fouille/acw02_esphome/docs/version_xiao_esp32_C3_C6.md

# XIAO ESP32 C3-C6 version
## 🧩 PCB

### 📂 Gerber files available in the `PCB/` directory:

#### 🟢 Stable version (v1.0) :
📥 [Download GERBER file](https://github.com/devildant/acw02_esphome/raw/main/PCB/lolin_c3_xiao_c3_xiao_c6/v1.0/Gerber_climEspHome_esp32_lolin_c3_xiao_c3_c6_PCB_climEspHome_esp32_lolin_c3_xia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)

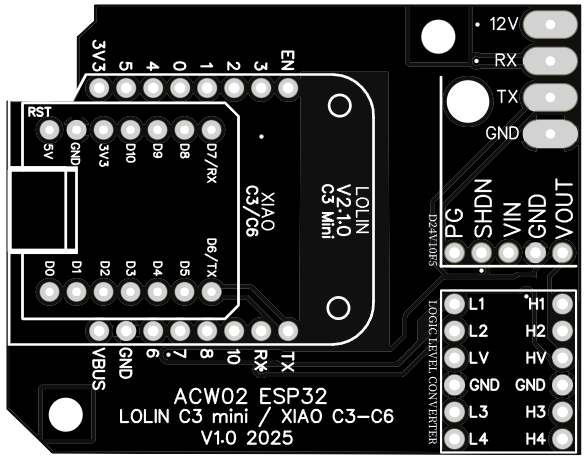
[picture p1: PCB/images/pcb/front-v1.0-C3-C6.PNG]
front
  
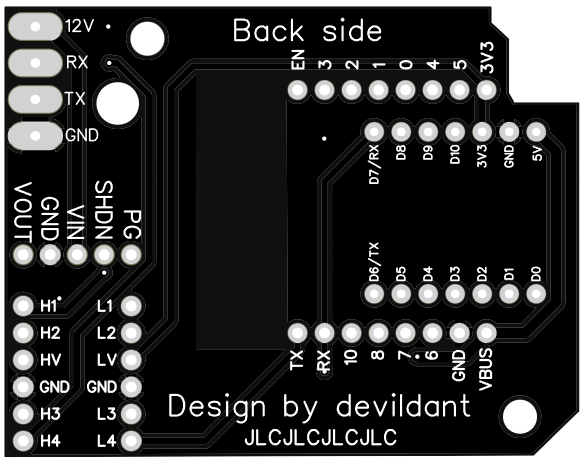
[picture p2: PCB/images/pcb/back-v1.0-C3-C6.PNG]
back


---

### 📦 Components

- **[ESP32 xiao C3 or C6 (x1)]**
  - **[LOLIN ESP32 C3 (x1)](https://www.seeedstudio.com/Seeed-XIAO-ESP32C3-p-5431.html)**  
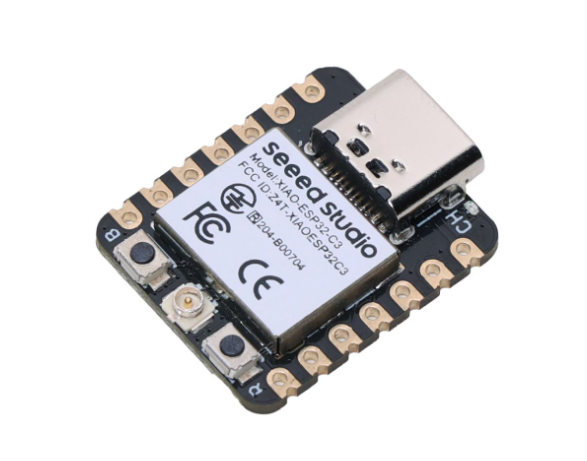
[picture p3: PCB/images/components/XIAO-ESP32-C3.PNG]
  
  - **[LOLIN ESP32 C6 (x1)](https://www.seeedstudio.com/Seeed-Studio-XIAO-ESP32C6-p-5884.html)**  
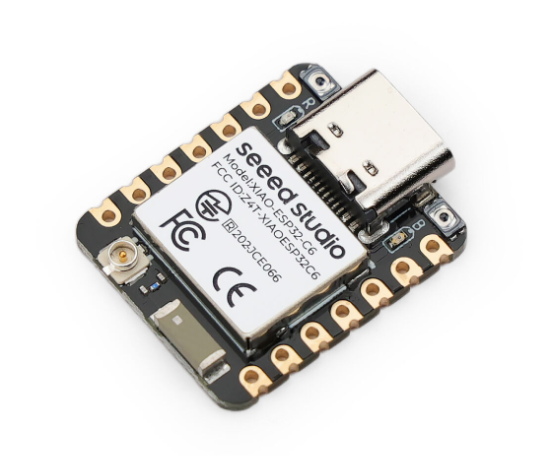
[picture p4: PCB/images/components/XIAO-ESP32-C6.PNG]
  
    - **[external antenna (for c6 only because not provide, and internal antenna has very poor reception) (x1)](https://www.seeedstudio.com/2-4GHz-FPC-Antenna-2-9dBi-for-XIAO-ESP32C3-p-6439.html)**  
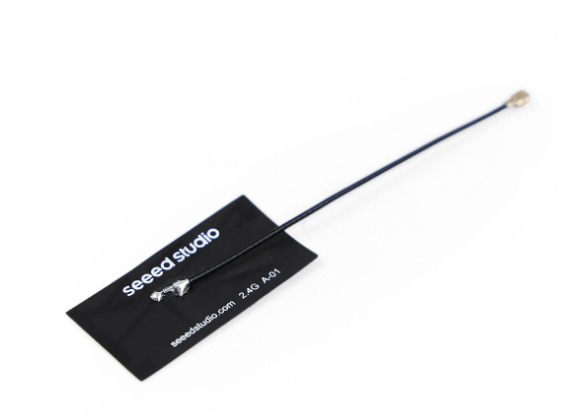
[picture p5: PCB/images/components/XIAO-ESP32-C6-antenna.PNG]
    

- **[7 pins male 2.54mm (x2): MaleL7.5-1X7P](https://fr.aliexpress.com/item/1005007128029220.html)**  
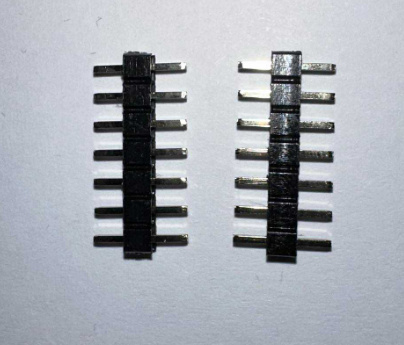
[picture p6: PCB/images/components/7 pin male 2.54.PNG]
MaleL7.5-1X5P
  

  ---
  
  ### 🧵 PCB Soldering & Wiring
  
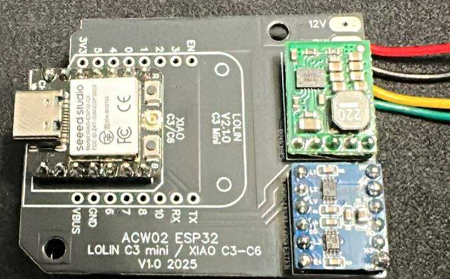
[picture p7: PCB/images/components/pcb front-xiao-C3.PNG]
pcb front xiao c3
    
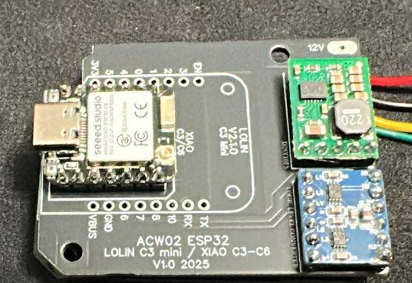
[picture p8: PCB/images/components/pcb front-xiao-C6.PNG]
pcb front xiao c6
    
  
  - RED = 12V  
  - BLACK = RX  
  - YELLOW = TX  
  - GREEN = GND

---

### 🧰 Solder Board Helper

[solder board ESP32 C3-C6.stl](https://github.com/devildant/acw02_esphome/raw/main/3Dfiles/LOLIN-C3-XIAO-C3-C6/solder%20board%20ESP32%20C3-C6.stl)  
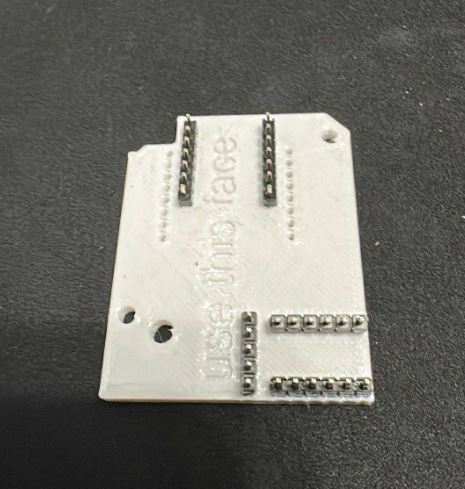
[picture p9: 3Dfiles/images/solder board1-xiao-c3-c6.jpg]
solder1
  
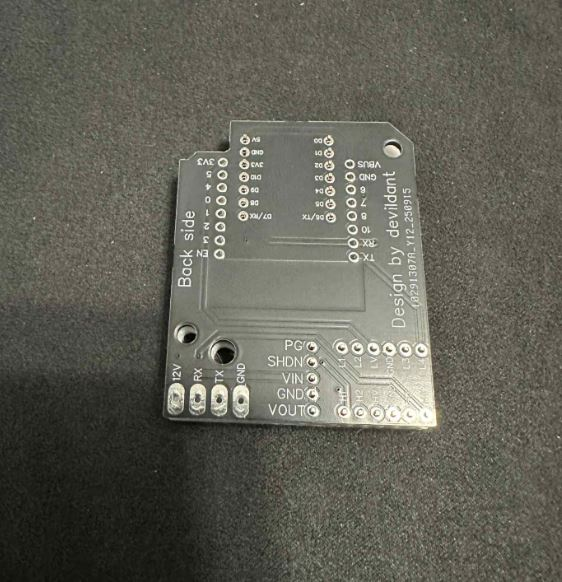
[picture p10: 3Dfiles/images/solder board2-xiao-c3-c6.jpg]
solder2
