fouille/acw02_esphome/docs/version_lolin_esp32_C3.md

# LOLIN ESP32 C3 MINI version
## 🧩 PCB

### 📂 Gerber files available in the `PCB/` directory:

#### 🟢 Stable version (v1.0) :
📥 [Download GERBER file](https://github.com/devildant/acw02_esphome/raw/main/PCB/lolin_c3_xiao_c3_xiao_c6/v1.0/Gerber_climEspHome_esp32_lolin_c3_xiao_c3_c6_PCB_climEspHome_esp32_lolin_c3_xia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)

front  
back

---

### 📦 Components

- **[LOLIN ESP32 C3 mini (x1)](https://www.wemos.cc/en/latest/c3/c3_mini.html)**  
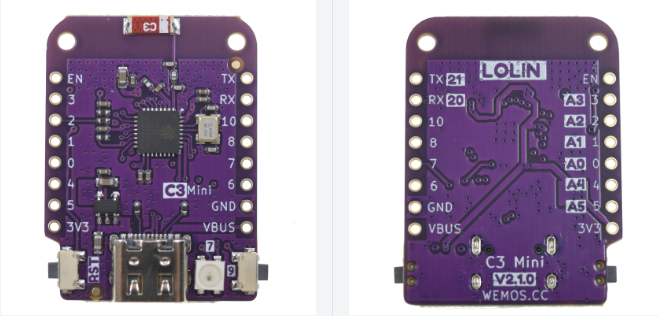
[picture p11: PCB/images/components/LOLIN-ESP32-C-MINI.PNG]
ESP32
  

- **[8 pins male 2.54mm (x2): MaleL7.5-1X8P](https://fr.aliexpress.com/item/1005007128029220.html)**  
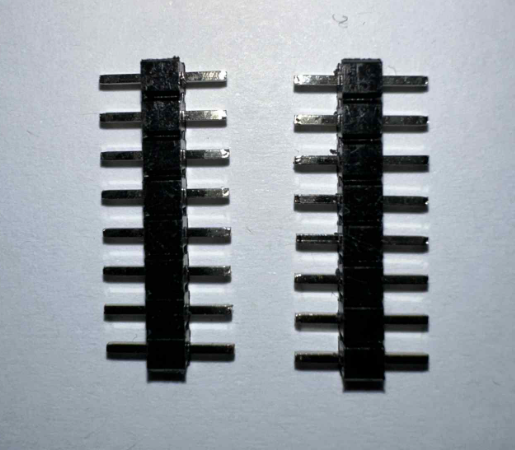
[picture p12: PCB/images/components/8 pin male 2.54.PNG]
MaleL7.5-1X5P
  

  ---
  
  ### 🧵 PCB Soldering & Wiring
  
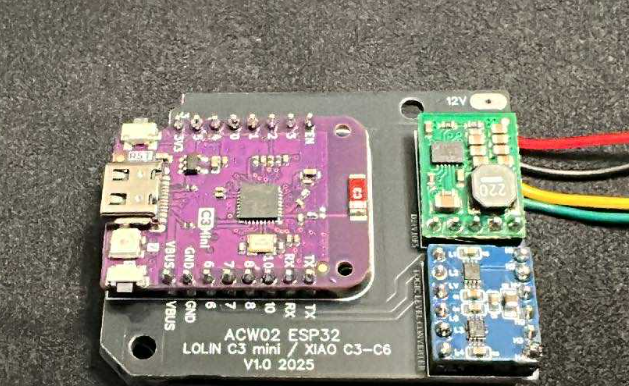
[picture p13: PCB/images/components/pcb front-lolin-c3.PNG]
pcb front
    
  
  - RED = 12V  
  - BLACK = RX  
  - YELLOW = TX  
  - GREEN = GND

---

### 🧰 Solder Board Helper

[solder board ESP32 C3-C6.stl](https://github.com/devildant/acw02_esphome/raw/main/3Dfiles/LOLIN-C3-XIAO-C3-C6/solder%20board%20ESP32%20C3-C6.stl)  
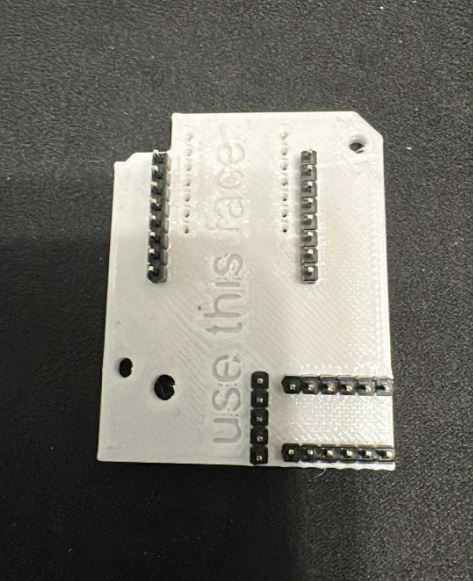
[picture p14: 3Dfiles/images/solder board1-lolin-c3.jpg]
solder1
  
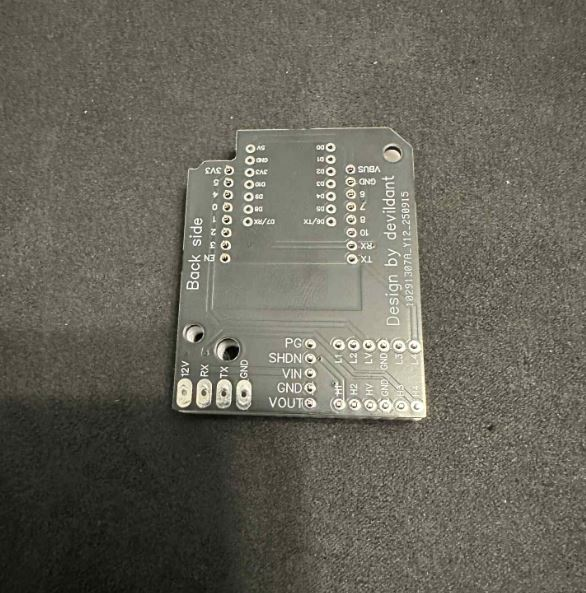
[picture p15: 3Dfiles/images/solder board2-lolin-c3.jpg]
solder2
