fouille/acw02_esphome/docs/en/README.md

# ACW02 Documentation (English)

Welcome to the complete English documentation for the ACW02 project.

## 🚀 Quick Start

1. **[Installation](installation/README.md)** - Complete installation guides
2. **[Hardware Selection](hardware/README.md)** - Choose your ESP32 board
3. **[Usage Guide](usage/README.md)** - Configure and use your module
4. **[Troubleshooting](usage/troubleshooting.md)** - Solve common issues

## 📋 Table of Contents

### Installation
- **[Installation Overview](installation/README.md)** - All installation methods
- **[macOS Installation](installation/macos.md)** - Direct installation on macOS
- **[Windows Installation](installation/windows.md)** - Direct installation on Windows
- **[Docker Installation](installation/docker.md)** - Using Docker containers
- **[Home Assistant Add-on](installation/ha-addon.md)** - ESPHome add-on method

### Hardware
- **[Hardware Overview](hardware/README.md)** - Board comparison and selection
- **[ESP32 D1 Mini](hardware/d1-mini.md)** - Original version with level shifter
- **[LOLIN C3](hardware/lolin-c3.md)** - Compact version without level shifter
- **[XIAO C3/C6](hardware/xiao-c3-c6.md)** - Ultra-compact versions

### Usage
- **[Getting Started](usage/README.md)** - First steps and basic configuration
- **[Interface Details](usage/interface.md)** - Complete interface description
- **[Home Assistant Integration](usage/home-assistant.md)** - HA setup and configuration
- **[Troubleshooting](usage/troubleshooting.md)** - Common problems and solutions

### Advanced Features
- **[Advanced Configuration](advanced/README.md)** - Advanced features overview
- **[MQTT Reference](advanced/mqtt-reference.md)** - Every topic and command
- **[MQTT-Only Mode](advanced/mqtt-only.md)** - Configuration without Home Assistant
- **[Jeedom Integration](advanced/jeedom.md)** - Integration with Jeedom
- **[Custom Presets](advanced/custom-presets.md)** - Creating custom presets
- **[Multi-Zone Setup](advanced/multi-zone.md)** - Multiple unit management
- **[Security Configuration](advanced/security.md)** - Security and encryption
- **[Monitoring](advanced/monitoring.md)** - System monitoring and diagnostics

## 🌍 Other Languages

- **[🇫🇷 Documentation Française](../fr/README.md)** - Complete French documentation

## ⚠️ Important Notes

- Always check [compatibility](../compatibility.md) before installation
- Make sure to use the correct hardware version for your air conditioner
- Follow safety guidelines when working with electrical connections

## 🆘 Need Help?

1. Check the [troubleshooting guide](usage/troubleshooting.md)
2. Review the [compatibility matrix](../compatibility.md)
3. Consult the hardware-specific documentation
4. Check existing GitHub issues

---
*Last updated: December 2024*
