fouille/acw02_esphome/COMPATIBILITY.md

# ACW02 ESPHome Compatibility List

_This file is generated from issues labeled `Compatibility`._

## Airton

| Commercial Model | Ref Model | Status | Notes |
|---|---|---|---|
| 409944 | N/A | ❌ No | These air conditioners use the 409945 module, which although identical to the other wifi modules are different. |
| 409943 | SMVH12L-3A1A3NB(I) | ❌ No | These air conditioners use the 409945 module, which although identical to the other wifi modules are different. |
| 409942 | N/A | ❌ No | These air conditioners use the 409945 module, which although identical to the other wifi modules are different. |
| 409913 | SMVH09B-2A2A3NG | ✅ Yes | _No response_ |
| 409730 | SMVH09B-2A2A3NH(I) | ✅ Yes | _No response_ |
| 409733 | SMVH12B-3A2A3NG(I) | ✅ Yes | _No response_ |
| 409731 | SMVH12B-2A2A3NH(I) | ✅ Yes | _No response_ |

## Teknopoint

| Commercial Model | Ref Model | Status | Notes |
|---|---|---|---|
| TW-SKIV-12 | - | ✅ Yes | No ref model found |
| TW-SKIV-12 | N-TW-SMVH12A-3C1A3NG(I) | ✅ Yes | _No response_ |
