fouille/acw02_esphome/3Dfiles/images/antenna-flexF2.PNG

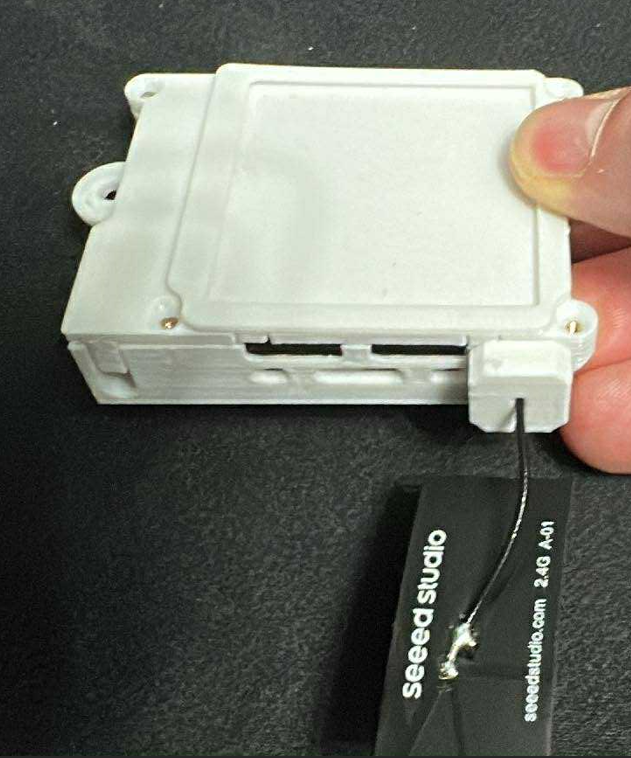
3Dfiles/images/antenna-flexF2.PNG
