fouille/acw02_esphome/3Dfiles/images/antenna-flexF.PNG

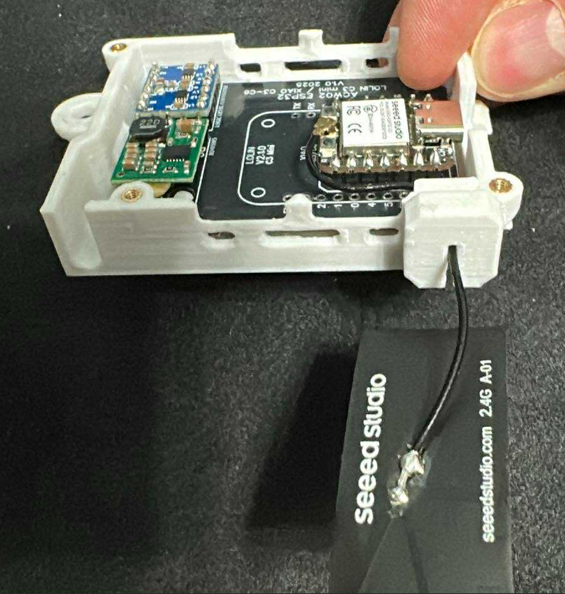
3Dfiles/images/antenna-flexF.PNG
