fouille/acw02_esphome/3Dfiles/images/antenna-flexH2.PNG

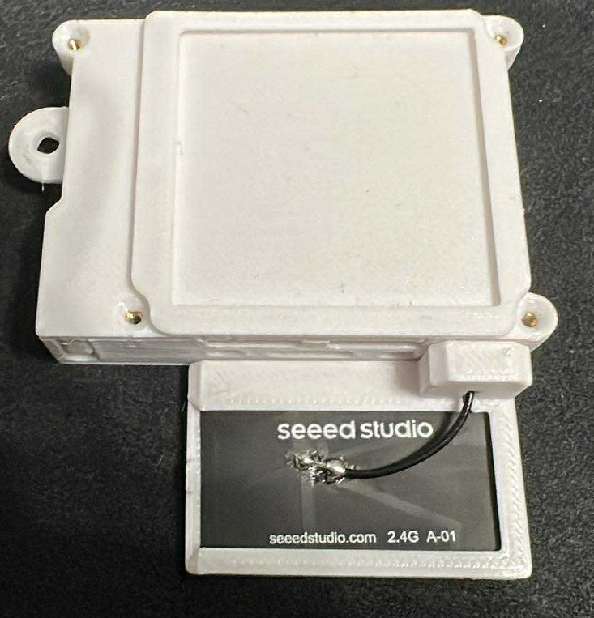
3Dfiles/images/antenna-flexH2.PNG
