fouille/acw02_esphome/3Dfiles/images/antenna-flexH.PNG

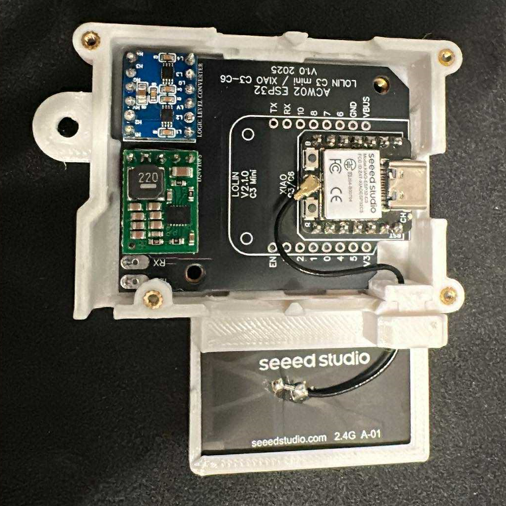
3Dfiles/images/antenna-flexH.PNG
