fouille/acw02_esphome/3Dfiles/images/antenna-flexV2.PNG

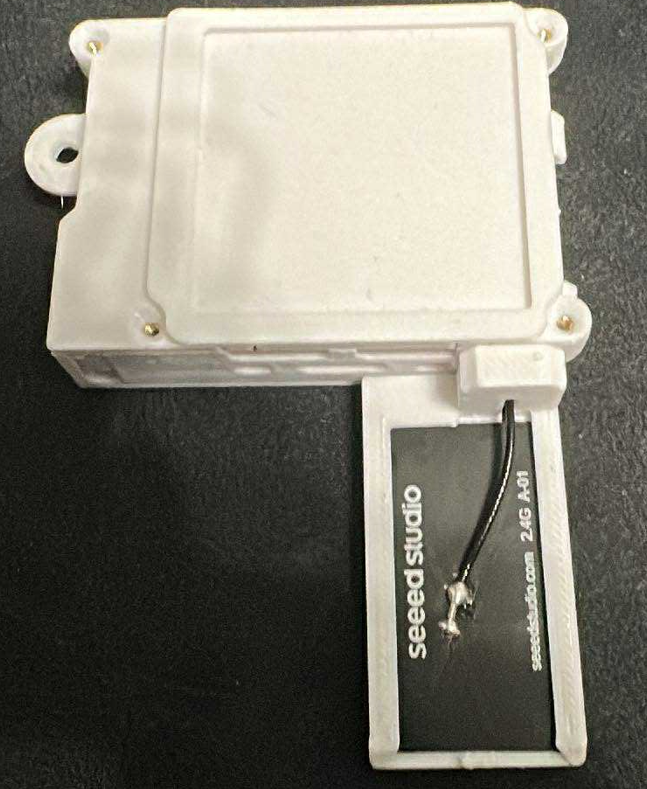
3Dfiles/images/antenna-flexV2.PNG
