fouille/acw02_esphome/3Dfiles/images/antenna-flexV.PNG

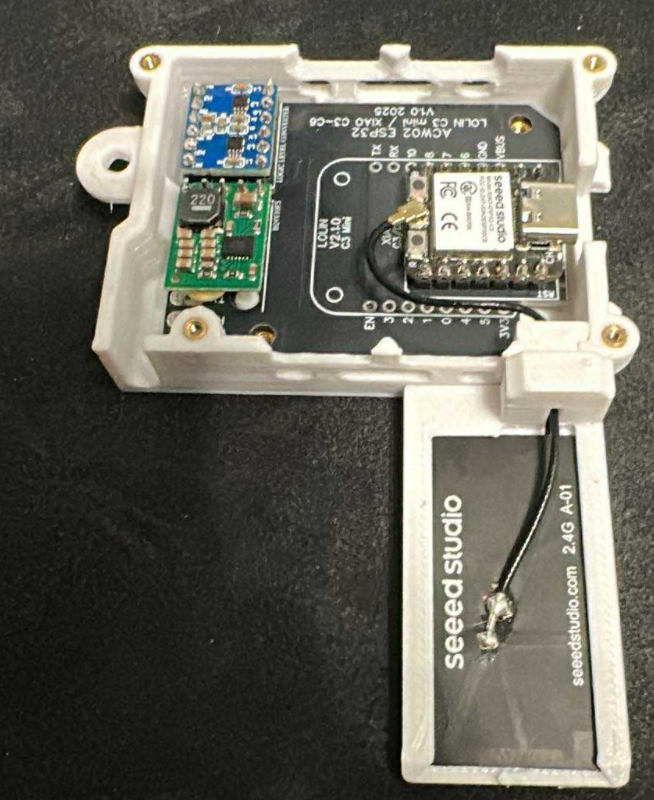
3Dfiles/images/antenna-flexV.PNG
