fouille/acw02_esphome/3Dfiles/images/antenna-rigid.PNG

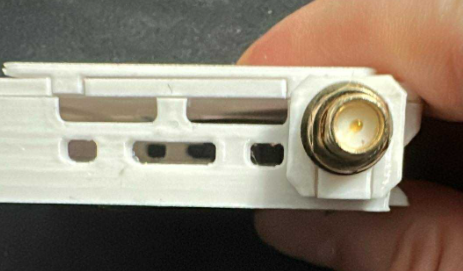
3Dfiles/images/antenna-rigid.PNG
