fouille/acw02_esphome/PCB/logic_level_converter/annexe/image.PNG

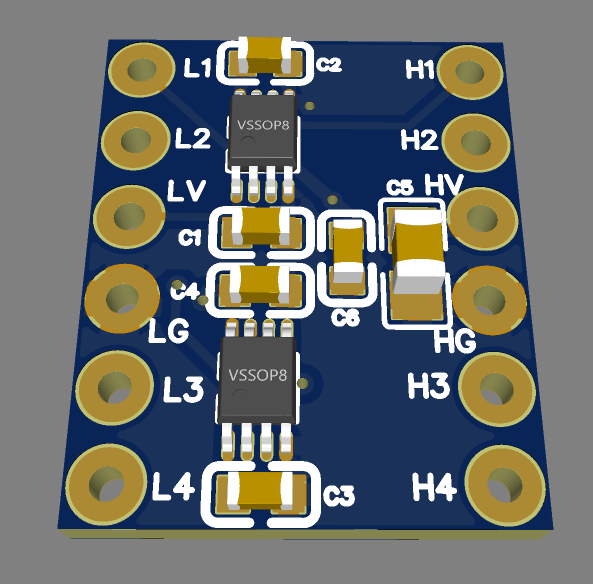
PCB/logic_level_converter/annexe/image.PNG
