fouille/acw02_esphome/3Dfiles/D1-MIMI/button.stl

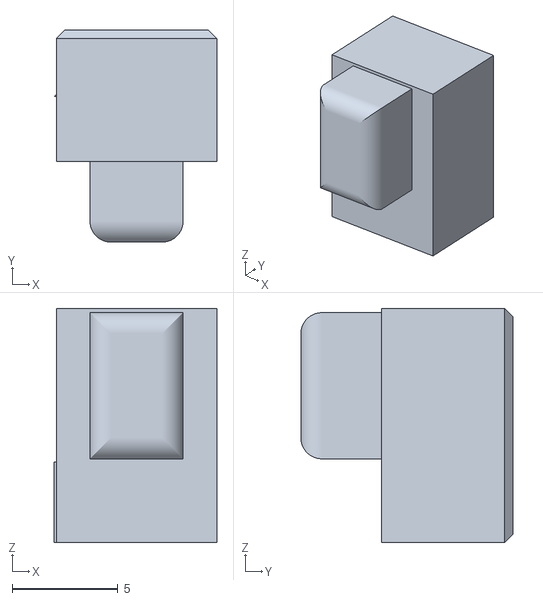
[picture p36: CAD file, 2025-09-27]
3Dfiles/D1-MIMI/button.stl
7.67 x 10.0 x 11.0
