fouille/acw02_esphome/3Dfiles/LOLIN-C3-XIAO-C3-C6/support antenna flex horizontal.stl

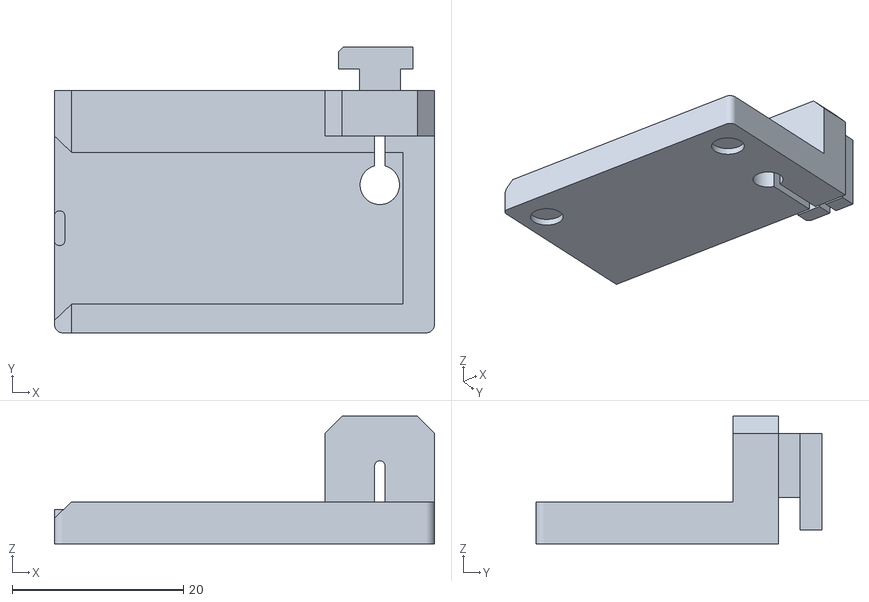
[picture p38: CAD file, 2025-09-27]
3Dfiles/LOLIN-C3-XIAO-C3-C6/support antenna flex horizontal.stl
44.4 x 33.4 x 14.9
