fouille/acw02_esphome/hardware/3d-files/LOLIN-C3-XIAO-C3-C6/solder board ESP32 C3-C6.stl

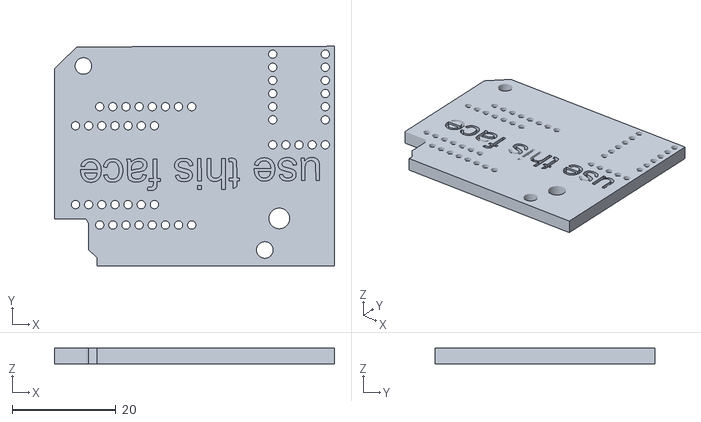
[picture p39: CAD file, 2026-10-30]
hardware/3d-files/LOLIN-C3-XIAO-C3-C6/solder board ESP32 C3-C6.stl
54.1 x 42.4 x 3.00
