fouille/acw02_esphome/hardware/3d-files/support for airton/support airton.stl

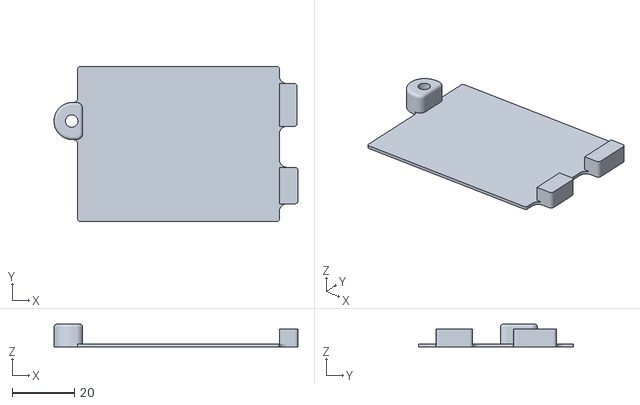
[picture p40: CAD file, 2026-10-30]
hardware/3d-files/support for airton/support airton.stl
78.7 x 50.0 x 7.40
