fouille/acw02_esphome/notUsed/proto pcb for replace level shiffter/annexe/PCB_uart-conv_2025-08-23.dxf

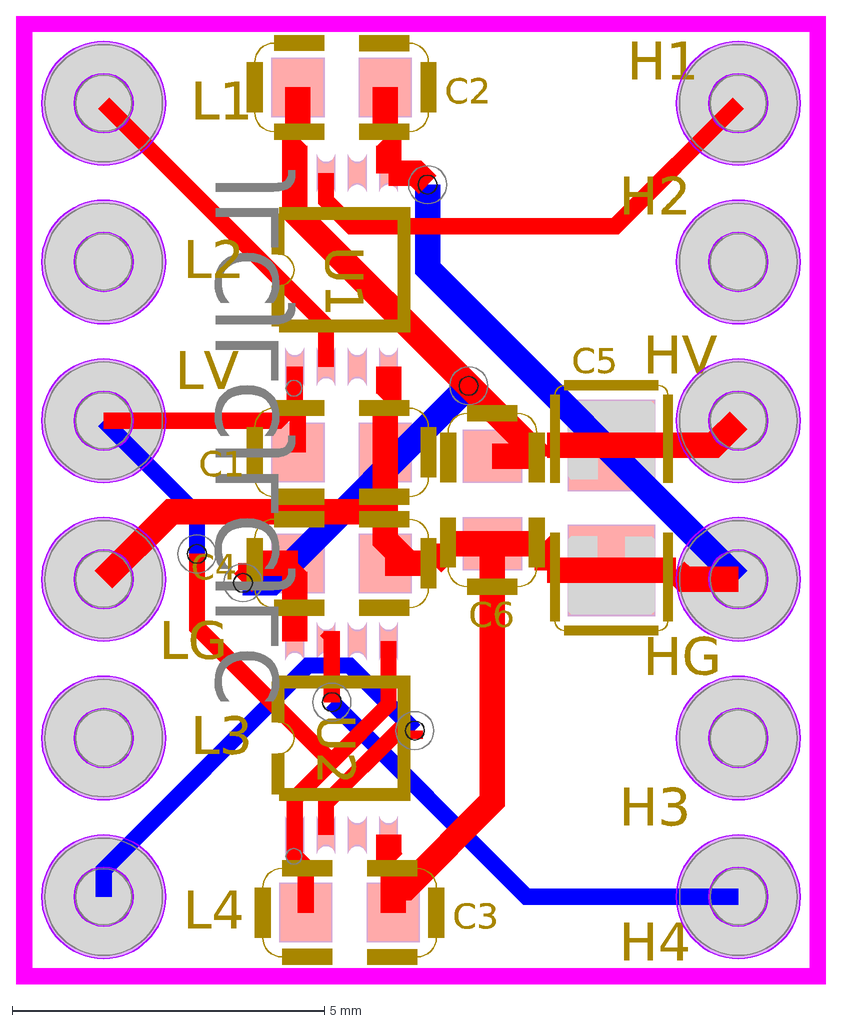
[picture p41: CAD file, 2025-08-23]
notUsed/proto pcb for replace level shiffter/annexe/PCB_uart-conv_2025-08-23.dxf
JLCJLCJLCJLC
U1
U2
H1
H2
H3
H4
HG
HV
L1
L2
L3
L4
LG
LV
C5
C1
C2
C3
C4
C6
