fouille/acw02_esphome/PCB/esp32_D1_mini_wroom32/v1.1/dxf/PCB_climEspHome_esp32_d1_mini_v1.1_2025-09-08.dxf

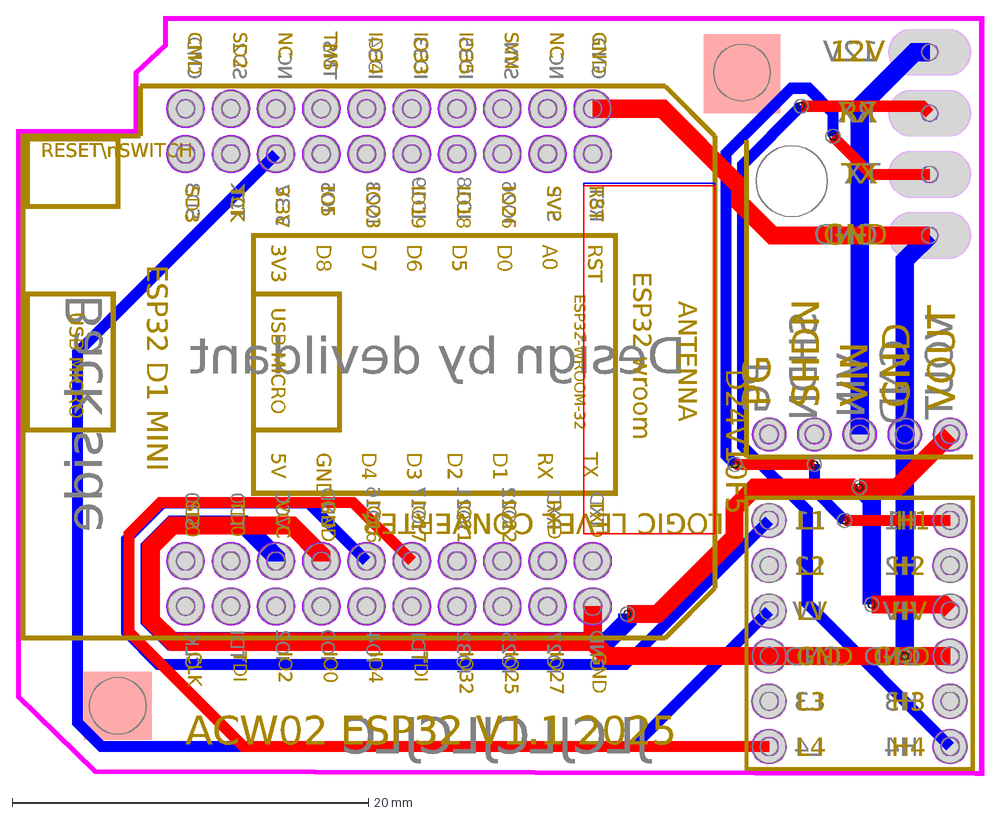
[picture p42: CAD file, 2025-09-08]
PCB/esp32_D1_mini_wroom32/v1.1/dxf/PCB_climEspHome_esp32_d1_mini_v1.1_2025-09-08.dxf
H1
H2
HV
GND
H3
H4
L4
L3
LV
L2
L1
VOUT
VIN
SHDN
PG
12V
RX
TX
IO27
IO25
IO32
TDI
IO4
IO0
IO2
CLK
SD0
TD0
VCC
IO16
IO17
IO21
IO22
RXD
TXD
Back side
Design by devildant
NC
SVN
IO35
IO33
IO34
TMS
SD2
CMD
SD3
TCK
3.3V
IO5
IO23
IO19
IO18
IO26
SVP
RST
JLCJLCJLCJLC
ACW02 ESP32 V1.1 2025
D24V10F5
LOGIC LEVEL CONVERTER
ESP32 D1 MINI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
