fouille/acw02_esphome/PCB/logic_level_converter/annexe/PCB_uart-conv_2025-09-10.dxf

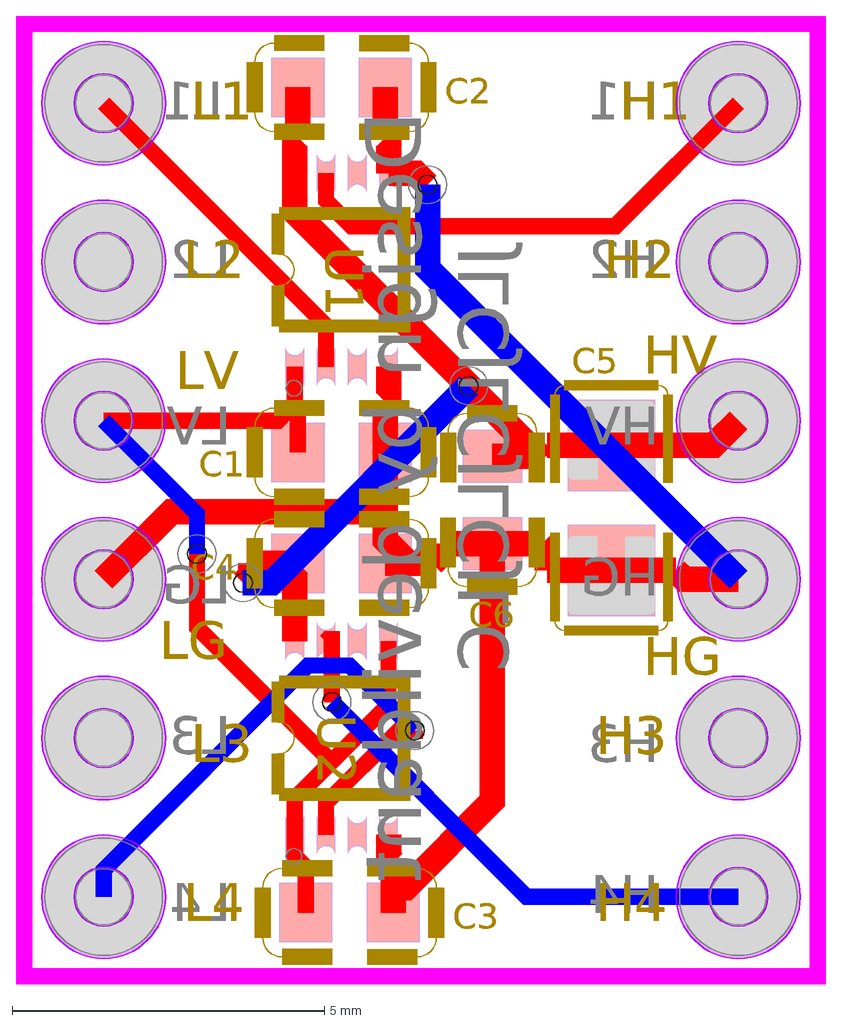
[picture p43: CAD file, 2025-09-10]
PCB/logic_level_converter/annexe/PCB_uart-conv_2025-09-10.dxf
JLCJLCJLCJLC
Design by devildant
HV
H2
H1
HG
H3
H4
L4
L3
LG
LV
L2
L1
U1
U2
C5
C1
C2
C3
C4
C6
