fouille/acw02_esphome/PCB/lolin_c3_xiao_c3_xiao_c6/v1.0/dxf/PCB_climEspHome_esp32_lolin_c3_xiao_c3_c6_2025-09-27.dxf

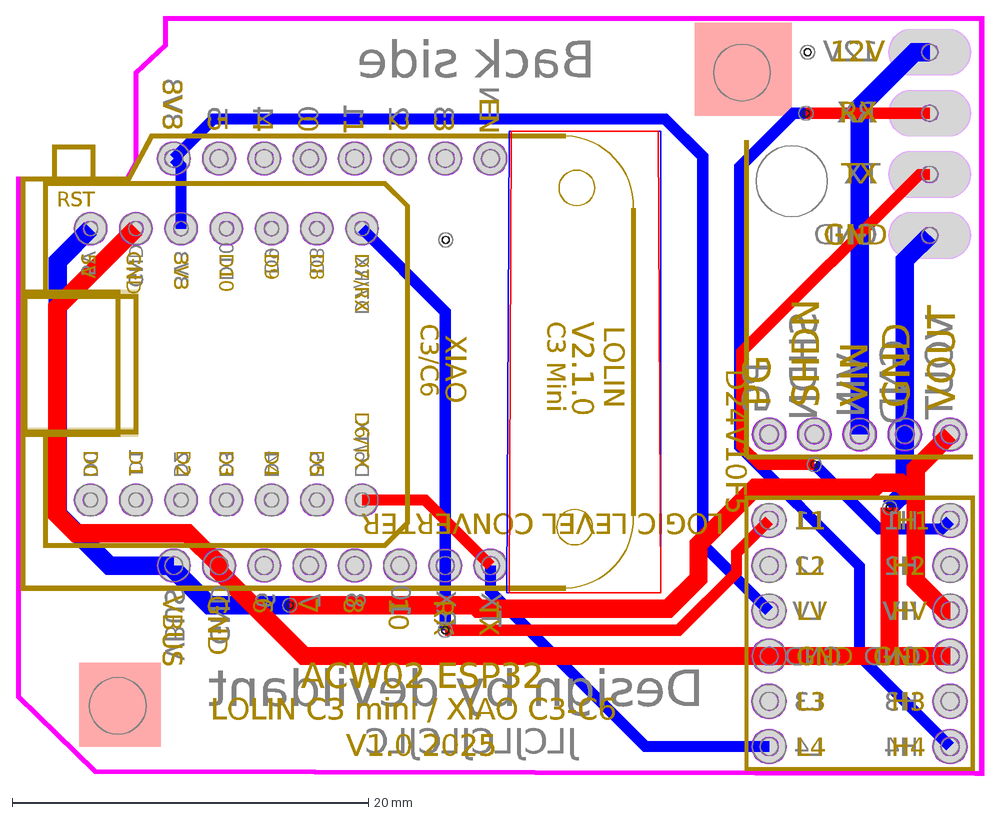
[picture p44: CAD file, 2025-09-13]
PCB/lolin_c3_xiao_c3_xiao_c6/v1.0/dxf/PCB_climEspHome_esp32_lolin_c3_xiao_c3_c6_2025-09-27.dxf
H1
H2
HV
GND
H3
H4
L4
L3
LV
L2
L1
VOUT
VIN
SHDN
PG
12V
RX
TX
Back side
Design by devildant
JLCJLCJLCJLC
EN
3
2
1
0
4
5
3V3
VBUS
6
7
8
10
D7/RX
D8
D9
D10
5V
D0
D1
D2
D3
D4
D5
D6/TX
ACW02 ESP32
V2.1.0
V1.0 2025
C3/C6
LOLIN C3 mini / XIAO C3-C6
XIAO
LOLIN
C3 Mini
RST
D24V10F5
LOGIC LEVEL CONVERTER
