fouille/acw02_esphome/3Dfiles/D1-MIMI/Version 2/acw02 case top cable with thermo air flow.stl

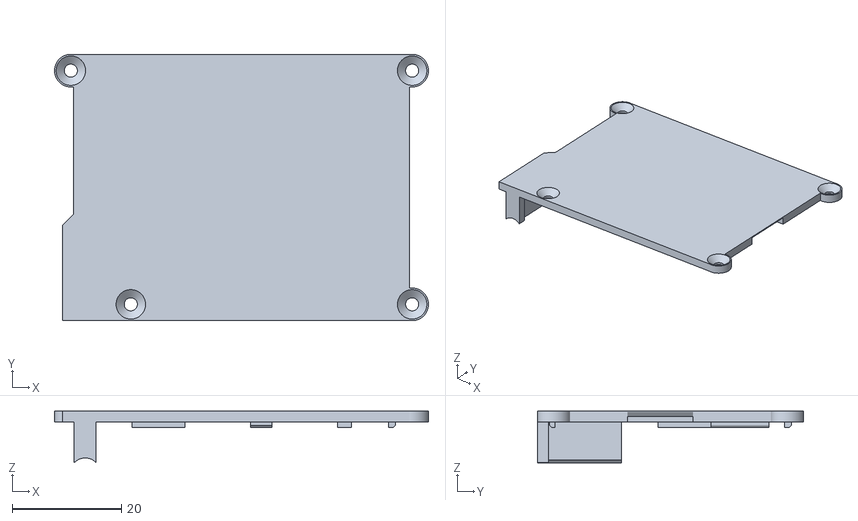
[picture p45: CAD file, 2025-09-27]
3Dfiles/D1-MIMI/Version 2/acw02 case top cable with thermo air flow.stl
68.6 x 48.9 x 9.49
