fouille/acw02_esphome/3Dfiles/LOLIN-C3-XIAO-C3-C6/support antenna rigid part B.stl

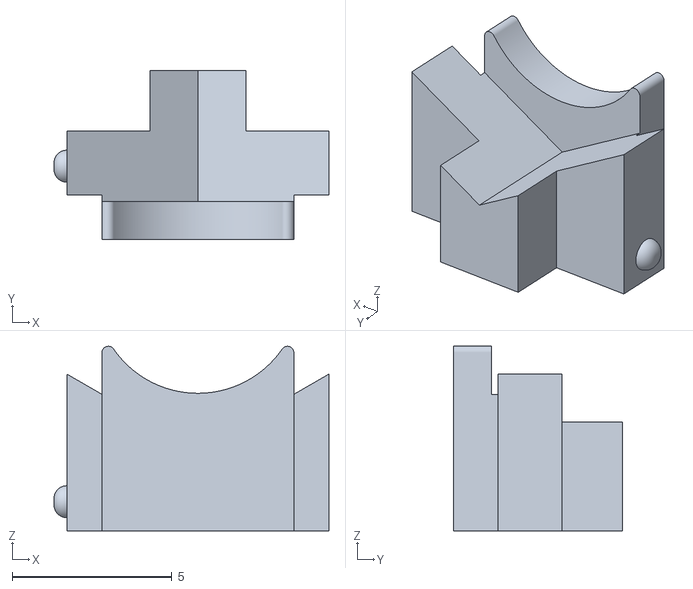
[picture p46: CAD file, 2025-09-27]
3Dfiles/LOLIN-C3-XIAO-C3-C6/support antenna rigid part B.stl
8.60 x 5.30 x 5.77
