fouille/acw02_esphome/3Dfiles/LOLIN-C3-XIAO-C3-C6/support antenna flex vertical.stl

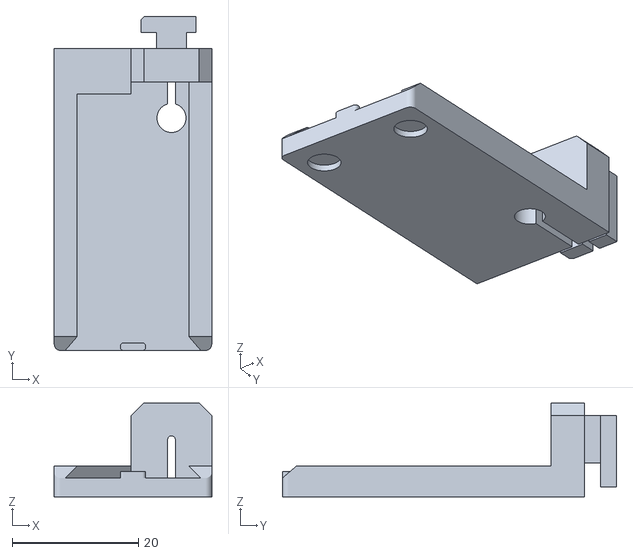
[picture p48: CAD file, 2025-09-27]
3Dfiles/LOLIN-C3-XIAO-C3-C6/support antenna flex vertical.stl
25.0 x 53.0 x 14.9
