fouille/acw02_esphome/3Dfiles/LOLIN-C3-XIAO-C3-C6/support antenna flex free.stl

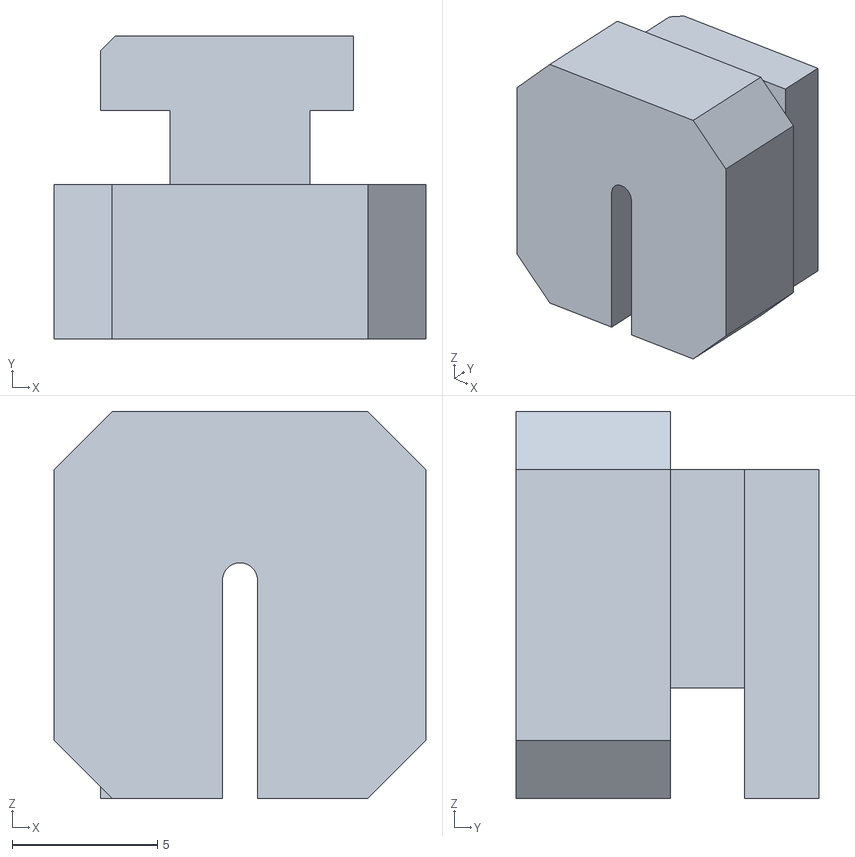
[picture p50: CAD file, 2025-09-27]
3Dfiles/LOLIN-C3-XIAO-C3-C6/support antenna flex free.stl
12.8 x 10.4 x 13.3
