fouille/acw02_esphome/3Dfiles/LOLIN-C3-XIAO-C3-C6/support antenna rigid part A.stl

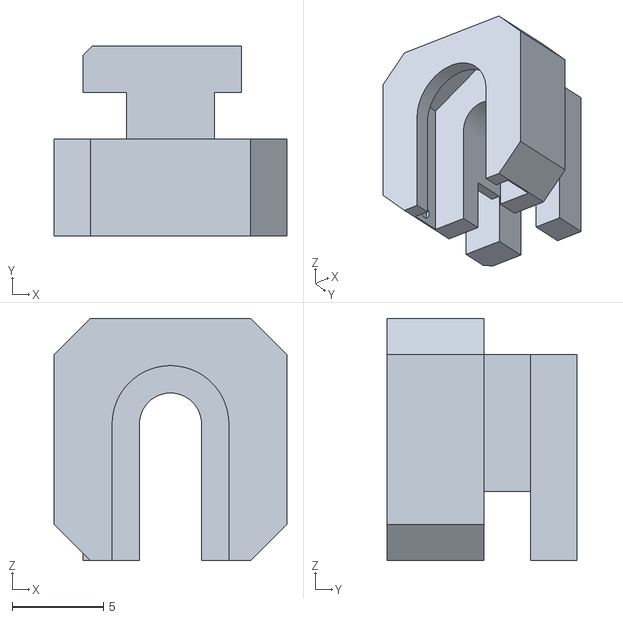
[picture p51: CAD file, 2025-09-27]
3Dfiles/LOLIN-C3-XIAO-C3-C6/support antenna rigid part A.stl
12.8 x 10.4 x 13.3
