fouille/acw02_esphome/3Dfiles/D1-MIMI/Version 1/acw02 case top.stl

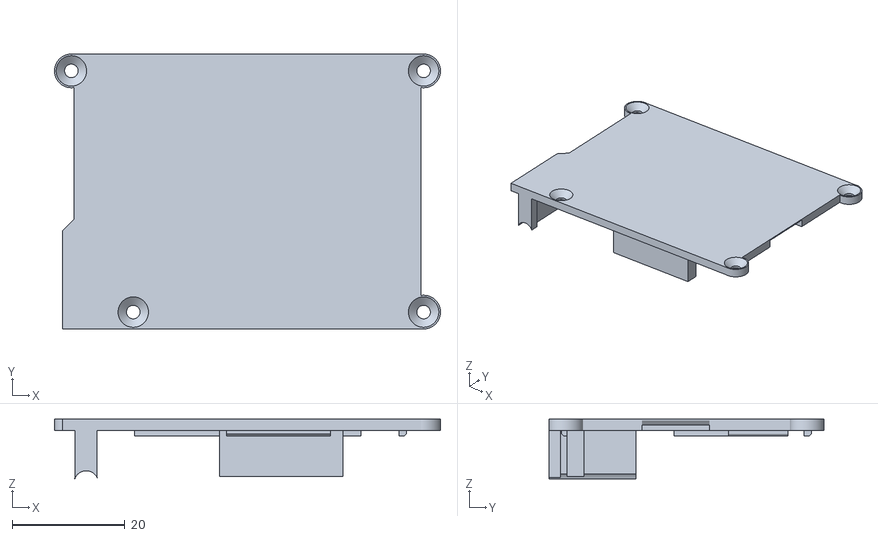
[picture p53: CAD file, 2025-09-27, an earlier design]
3Dfiles/D1-MIMI/Version 1/acw02 case top.stl
68.6 x 48.9 x 10.6
