fouille/acw02_esphome/(list of files, cad)

Other CAD files:
3Dfiles/D1-MIMI/Version 1/acw02 case top cable with thermo.stl
3Dfiles/D1-MIMI/Version 1/acw02 v43.f3d
PCB/esp32_D1_mini_wroom32/v1.0/dxf/PCB_climEspHome_esp32_d1_mini_2025-07-17 (1).dxf
hardware/3d-files/support for airton/acw02 v75.f3d
