fouille/acw02_esphome/docs/install_from_windows_directly.md

# 🔧 Build from Windows

### 🐍 Python

Install Python 3.11 from the Microsoft Store.

---

## 📦 Update pip

```powershell
pip install --upgrade pip
```

---

## 🧱 Install ESPHome

```powershell
pip install esphome==2025.9.3
```

---

## 🛠️ Build

To build the firmware in French:
```powershell
build-fr.bat
```

Or in English:
```powershell
build-en.bat
```
