fouille/acw02_esphome/3Dfiles/images/antenna-rigid-assembly.PNG

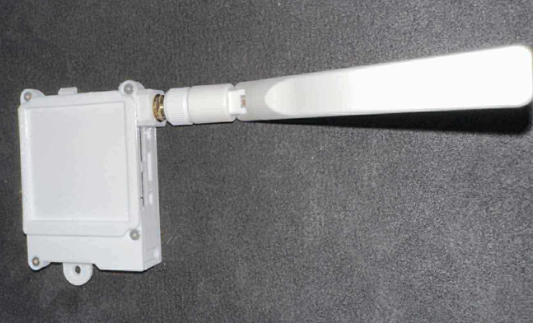
3Dfiles/images/antenna-rigid-assembly.PNG
