fouille/acw02_esphome/(list of files, drawings)

Other design files:
notUsed/proto pcb for replace level shiffter/annexe/easyidea/PCB_PCB_uart-conv_2025-08-23.json
PCB/esp32_D1_mini_wroom32/v1.0/easyeda/PCB_PCB_climEspHome_esp32_d1_mini_2025-07-17.json
PCB/esp32_D1_mini_wroom32/v1.1/easyeda/PCB_PCB_climEspHome_esp32_d1_mini_v1.1_2025-09-08.json
PCB/logic_level_converter/annexe/easyidea/PCB_PCB_uart-conv_2025-09-10.json
PCB/lolin_c3_xiao_c3_xiao_c6/v1.0/easyeda/PCB_PCB_climEspHome_esp32_lolin_c3_xiao_c3_c6_2025-09-27.json
