fouille/acw02_esphome/firmware/components/acw02/acw02.cpp

#include "acw02.h"
#include "esphome/core/log.h"
#include "esphome/core/helpers.h"

#include <cinttypes>
#include <cmath>

#ifdef CONFIG_IDF_TARGET_ESP32C6
#include "driver/gpio.h"
#endif

namespace esphome {
  namespace acw02 {

    void ACW02::setup() {
      #if defined(DLOCALE_LANG)
        app_lang_ = DLOCALE_LANG;
      #else
        app_lang_ = "en";
      #endif
      #if defined(DBOARD)
        app_board_ = DBOARD;
      #endif

      // force use external Wi-Fi antenna (XIAO ESP32-C6)
      #if CONFIG_IDF_TARGET_ESP32C6
        // GPIO3 -> LOW
        gpio_reset_pin(GPIO_NUM_3);
        gpio_set_direction(GPIO_NUM_3, GPIO_MODE_OUTPUT);
        gpio_set_level(GPIO_NUM_3, 0);

        // GPIO14 -> HIGH
        gpio_reset_pin(GPIO_NUM_14);
        gpio_set_direction(GPIO_NUM_14, GPIO_MODE_OUTPUT);
        gpio_set_level(GPIO_NUM_14, 1);

        ESP_LOGW(TAG, "RF switch set for XIAO ESP32-C6: external Wi-Fi antenna enabled");
      #endif

      mqtt_connexion();
      app_name_ = App.get_name();
      app_friendly_name_ = App.get_friendly_name();
      app_sanitize_name_ = sanitize_name(app_name_);
      app_mac_ = get_mac_address();

      send_static_command_basic(keepalive_frame_);
      presets_list_element_config_ = PRESETS_LIST_ELEMENT_CONFIG_DEFAULT;
      presets_list_element_ = get_localized_name(app_lang_, "presetNone");
      mute_pref_ = global_preferences->make_preference<bool>(1U, "ac_mute");
      mute_pref_.load(&mute_);
      disable_mode_auto_pref_ = global_preferences->make_preference<bool>(2U, "ac_disable_mode_auto");
      disable_mode_auto_pref_.load(&disable_mode_auto_);
      disable_mode_heat_pref_ = global_preferences->make_preference<bool>(3U, "ac_disable_mode_heat");
      disable_mode_heat_pref_.load(&disable_mode_heat_);
      disable_mode_dry_pref_ = global_preferences->make_preference<bool>(4U, "ac_disable_mode_dry");
      disable_mode_dry_pref_.load(&disable_mode_dry_);
      disable_mode_fan_pref_ = global_preferences->make_preference<bool>(5U, "ac_disable_mode_fan");
      disable_mode_fan_pref_.load(&disable_mode_fan_);
      disable_swing_vertical_pref_ = global_preferences->make_preference<bool>(6U, "ac_disable_swing_vertical");
      disable_swing_vertical_pref_.load(&disable_swing_vertical_);
      disable_swing_horizontal_pref_ = global_preferences->make_preference<bool>(7U, "ac_disable_swing_horizontal");
      disable_swing_horizontal_pref_.load(&disable_swing_horizontal_);
      option_recalculate_climate_pref_ = global_preferences->make_preference<bool>(8U, "ac_option_recalculate_climate");
      option_recalculate_climate_pref_.load(&option_recalculate_climate_);
      option_G1_MQTT_pref_ = global_preferences->make_preference<bool>(9U, "ac_option_g1_mqtt");
      option_G1_MQTT_pref_.load(&option_g1_mqtt_);
      previous_temp_c_pref_ = global_preferences->make_preference<bool>(10U, "ac_previous_temp_c");
      previous_temp_c_pref_.load(&previous_target_temp_c_);
      previous_temp_f_pref_ = global_preferences->make_preference<bool>(11U, "ac_previous_temp_f");
      previous_temp_f_pref_.load(&previous_target_temp_f_);
      auto_off_options_when_ac_off_pref_ = global_preferences->make_preference<bool>(12U, "ac_auto_off_options_when_ac_off");
      auto_off_options_when_ac_off_pref_.load(&auto_off_options_when_ac_off_);
      mute_next_cmd_after_on_delay_pref_ = global_preferences->make_preference<int>(13U, "ac_mute_after_power_on_delay");
      if (!mute_next_cmd_after_on_delay_pref_.load(&mute_next_cmd_after_on_delay_)) {
        mute_next_cmd_after_on_delay_ = 0;
      }
      mute_next_cmd_delay_pref_ = global_preferences->make_preference<int>(14U, "ac_mute_next_cmd_delay");
      if (!mute_next_cmd_delay_pref_.load(&mute_next_cmd_delay_)) {
        mute_next_cmd_delay_ = 0;
      }
      publish_stats_after_power_on_delay_pref_ = global_preferences->make_preference<int>(15U, "ac_publish_stats_after_power_on_delay");
      if (!publish_stats_after_power_on_delay_pref_.load(&publish_stats_after_power_on_delay_)) {
        publish_stats_after_power_on_delay_ = 0;
      }
      preset_pref_ = global_preferences->make_preference<bool>(16U, "ac_preset");
      preset_pref_.load(&preset_);
      load_presets_from_flash();

      set_timeout("test", 10000, [this]() {
        ESP_LOGD(TAG, "Setup %s ", "INIT");
        ESP_LOGD(TAG, "Board %s ", app_board_.c_str());
        ESP_LOGD(TAG, "MAC %s ", app_mac_.c_str());
        ESP_LOGD(TAG, "name %s ", app_name_.c_str());
        ESP_LOGD(TAG, "friendly name %s ", app_friendly_name_.c_str());
        ESP_LOGD(TAG, "sanitze name %s ", app_sanitize_name_.c_str());
        ESP_LOGD(TAG, "MQTT broker %s ", mqtt_broker_address_.c_str());
        ESP_LOGD(TAG, "MQTT username %s ", mqtt_username_.c_str());
        ESP_LOGD(TAG, "MQTT port %d ", mqtt_port_);
        ESP_LOGD(TAG, "Lang %s ", app_lang_.c_str());
        ESP_LOGD(TAG, "name %s ", get_localized_name(app_lang_, "climate").c_str());
        ESP_LOGD(TAG, "mode json %s ", build_options_json(app_lang_, "mode").c_str());
        ESP_LOGD(TAG, "fan json %s ", build_options_json(app_lang_, "fan").c_str());
        ESP_LOGD(TAG, "swing json %s ", build_options_json(app_lang_, "swing").c_str());
        //  send_static_command_basic(get_status_frame_);
      });
    }

    void ACW02::loop() {
      process_tx_queue();

      while (available()) {
        uint8_t byte = read();
        rx_buffer_.push_back(byte);
        last_rx_byte_time_ = millis();
      }

      // for check size rx buffer
      if (rx_buffer_.size() > rx_max_depth_) {
        rx_max_depth_ = rx_buffer_.size();
        ESP_LOGW(TAG, "RX max depth = %u", (unsigned)rx_max_depth_);
      }

      // Wait at least 10ms of silence before processing buffer
      if (!rx_buffer_.empty() && millis() - last_rx_byte_time_ > 10) {
        static const std::array<size_t, 4> VALID_SIZES = {13, 18, 28, 34};

        size_t offset = 0;
        while (rx_buffer_.size() - offset >= 13) {  // Minimum frame size
          bool found = false;

          for (size_t size : VALID_SIZES) {
            if (offset + size > rx_buffer_.size())
              continue;

            if (rx_buffer_[offset] != 0x7A || rx_buffer_[offset + 1] != 0x7A)
              continue;

            const uint8_t *start = rx_buffer_.data() + offset;
            uint16_t expected_crc = (start[size - 2] << 8) | start[size - 1];
            uint16_t computed_crc = crc16(start, size - 2);

            if (computed_crc == expected_crc) {
              std::vector<uint8_t> frame(start, start + size);
              ESP_LOGW(TAG, "RX: [%s]", format_hex_pretty(frame).c_str());
              decode_state(frame);
              offset += size;
              found = true;
              break;
            }
          }

          if (!found) {
            // Skip invalid start byte and retry
            offset++;
          }
        }

        // Remove processed bytes from rx_buffer_
        if (offset > 0)
          rx_buffer_.erase(rx_buffer_.begin(), rx_buffer_.begin() + offset);
      }

      check_timeout_retry();

      static uint32_t last_keepalive = 0;
      if (!ack_wait_ && millis() - last_keepalive > INTERVAL_INTERNAL_AC_KEEPALIVE && tx_queue_.empty()) {
        if (millis() - last_rx_byte_time_ > 200) {
          last_keepalive = millis();
          send_static_command_basic(keepalive_frame_);
        }
      }
    }

    void ACW02::set_mode_climate(const std::string &mode) {
      if (mode != "off") {
        const Mode previous_mode = mode_;
        power_on_ = true;
        mode_ = str_to_mode_climate(mode);
        if (mode_ != Mode::COOL) {
          set_eco_internal(false);
        } else {
          // force set if eco_ is true (if eco is not disable auto when off)
          set_eco_internal(eco_, eco_);
        }
        if (mode_ == Mode::FAN) night_ = false;
        if (mode_ == Mode::AUTO) {
          publish_discovery_climate_deref();
        }
        if (previous_mode == Mode::AUTO) {
          target_temp_c_ = previous_target_temp_c_;
          target_temp_f_ = previous_target_temp_f_;
          publish_discovery_climate_deref();
        }
      } else {
        power_on_ = false;
        reset_options_when_off();
      }
    }

    void ACW02::set_mode(const std::string &mode) {
      if (mode != key_to_txt(app_lang_, "mode", "OFF")) {
        const Mode previous_mode = mode_;
        power_on_ = true;
        mode_ = str_to_mode(app_lang_, mode);
        if (mode_ != Mode::COOL) {
          set_eco_internal(false);
        } else {
          // force set if eco_ is true (if eco is not disable auto when off)
          set_eco_internal(eco_, eco_);
        }
        if (mode_ == Mode::FAN) night_ = false;
        if (mode_ == Mode::AUTO) {
          publish_discovery_climate_deref();
        }
        if (previous_mode == Mode::AUTO) {
          target_temp_c_ = previous_target_temp_c_;
          target_temp_f_ = previous_target_temp_f_;
          publish_discovery_climate_deref();
        }
      } else {
        power_on_ = false;
        reset_options_when_off();
      }
    }

    void ACW02::set_swing(const std::string &pos) {
      swing_position_ = str_to_swing(app_lang_, pos);
    }

    void ACW02::set_swing_horizontal(const std::string &pos) {
      swing_horizontal_ = str_to_swing_horizontal(app_lang_, pos);
    }

    void ACW02::set_purifier(bool on) {
      if (power_on_) {
        purifier_ = on;
      } else {
        purifier_ = false;
      }
    }

    void ACW02::set_mute(bool on) {
      if (mute_ != on) {
        mute_ = on;
        mute_pref_.save(&mute_);
        publish_state();
      }
      
    }

    void ACW02::set_unit(const std::string &unit) {
      bool oldValue = use_fahrenheit_;
      bool newValue = (unit == "°F" || unit == "°f");

      if (oldValue != newValue) {
        use_fahrenheit_ = newValue;
        publish_discovery_climate(true);
        publish_discovery_temperature_number(true);
        publish_discovery_temperature_sensor(true);
      }
    }

    void ACW02::set_clean(bool on) {
      if (on != clean_) {
        if (on && (power_on_ || (mode_ != Mode::COOL && mode_ != Mode::DRY)))
        {
          power_on_ = false;
          if (mode_ != Mode::COOL && mode_ != Mode::DRY) {
            mode_ = Mode::COOL;
          }
          // disable FP for first cmd with set mode compatible with clean (without that if the AC is in not compatible code, this genereate useless retry)
          Frame_with_Fingerprint cmdWithoutFP = build_frame();
          cmdWithoutFP.fingerprint = 0;
          send_command_basic(cmdWithoutFP);
          force_clean_ = true;
          clean_ = on;
          set_timeout("clean_delay", 3000, [this, on]() {
            send_command_basic(build_frame(true));
            force_clean_ = false;
          });
        } else {
          clean_ = on;
          force_clean_ = false;
          send_command_basic(build_frame(true));
        }
      }
    }

    bool ACW02::set_temperature_c(float temp) {
      if (!use_fahrenheit_) {
        const uint8_t oldC = target_temp_c_;
        const uint8_t oldF = target_temp_f_;

        if (temp < 16) temp = 16;
        if (temp > 31) temp = 31;
        target_temp_f_ = static_cast<uint8_t>(celsius_to_fahrenheit(temp));
        target_temp_c_ = static_cast<uint8_t>(temp);
        if ((!eco_ && mode_ != Mode::AUTO) || !power_on_) {
          return true;
        } else {
          set_timeout("publishStateDelay", 100, [this, oldC, oldF]() {
            target_temp_f_ = oldF;
            target_temp_c_ = oldC;
            publish_state();
          });
        }
      }
      return false;
    }

    bool ACW02::set_temperature_f(float temp) {
      if (use_fahrenheit_) {
        const uint8_t oldC = target_temp_c_;
        const uint8_t oldF = target_temp_f_;

        if (temp < 61) temp = 61;
        if (temp > 88) temp = 88;
        target_temp_f_ = static_cast<uint8_t>(temp);
        target_temp_c_ = static_cast<uint8_t>(fahrenheit_to_celsius(temp));
        if ((!eco_ && mode_ != Mode::AUTO) || !power_on_) {
          return true;
        } else {
          set_timeout("publishStateDelay", 100, [this, oldC, oldF]() {
            target_temp_f_ = oldF;
            target_temp_c_ = oldC;
            publish_state();
          });
        }
      }
      return false;
    }

    bool ACW02::set_fan(const std::string &speed) {
      if (!eco_) {
        fan_ = str_to_fan(app_lang_, speed);
        return true;
      } else {
        ESP_LOGI(TAG, "Ignore command : mode ECO enabled");
        fan_ = str_to_fan(app_lang_, speed);
        set_timeout("publishStateDelay", 100, [this]() {
          fan_ = Fan::AUTO;
          publish_state();
        });
      }
      return false;
    }

    bool ACW02::set_display(bool on) {
      ESP_LOGI(TAG, "set display current : %s target : %s", display_ ? "on" : "off", on ? "on" : "off");
      if (display_ != on) {
        display_ = on;
        return true;
      }
      return false;
    }

    bool ACW02::set_eco(bool on) {
      if (eco_ != on) {
        if (power_on_) {
          if (mode_ == Mode::COOL) {
            return set_eco_internal(on);
          } else {
            eco_ = false;
          }
        } else {
          eco_ = false;
        }
      }
      return false;
    }

    bool ACW02::set_eco_internal(bool on, bool force) {
      if (eco_ != on || force) {
        eco_ = on;
        if (on) {
          night_ = false;
          previous_fan_ = fan_;
          fan_ = Fan::AUTO;
          recalculate_climate_depending_by_option();
          ESP_LOGI(TAG, "set_eco %s", "store previous fan and enable auto");
        } else {
          fan_ = previous_fan_;
          recalculate_climate_depending_by_option();
          ESP_LOGI(TAG, "set_eco %s", "restore previous");
        }
        return true;
      }
      return false;
    }

    bool ACW02::set_night(bool on) {
      if (power_on_) {
        if (mode_ == Mode::COOL || mode_ == Mode::DRY || mode_ == Mode::HEAT) {
          if (night_ != on) {
            night_ = on;
            if (night_) {
              if (eco_)
              {
                set_eco_internal(false);
              }
            }
            return true;
          }
        } else {
          night_ = false;
        }
      } else {
        night_ = false;
      }
      return false;
    }

    void ACW02::set_auto_off_options_when_ac_off(bool on) {
      if (auto_off_options_when_ac_off_ != on) {
        auto_off_options_when_ac_off_ = on;
        auto_off_options_when_ac_off_pref_.save(&auto_off_options_when_ac_off_);
        publish_state();
      }
    }

    void ACW02::set_mute_next_cmd_delay_string(const std::string &value) {
      if (value.empty() || !std::all_of(value.begin(), value.end(), ::isdigit)) {
        ESP_LOGI(TAG, "Invalid delay (non-numeric) : '%s'", value.c_str());
        mute_next_cmd_delay_ = 0;
        return;
      }
      // value ne contient que des chiffres : parse_number n'échoue qu'en cas de dépassement
      int delay = std::min<uint32_t>(parse_number<uint32_t>(value).value_or(60000), 60000);
      int prev = mute_next_cmd_delay_;
      mute_next_cmd_delay_ = delay;
      mute_next_cmd_delay_pref_.save(&mute_next_cmd_delay_);
      publish_state();
      if (mute_next_cmd_delay_text_ != nullptr && prev != mute_next_cmd_delay_) {
        mute_next_cmd_delay_text_->publish_state(
          std::to_string(delay)
        );
      }
      ESP_LOGI(TAG, "Delay saved : %d", delay);
    }

    void ACW02::set_mute_next_cmd_after_on_delay_string(const std::string &value) {
      if (value.empty() || !std::all_of(value.begin(), value.end(), ::isdigit)) {
        ESP_LOGI(TAG, "Invalid delay (non-numeric) : '%s'", value.c_str());
        mute_next_cmd_after_on_delay_ = 0;
        return;
      }
      // value ne contient que des chiffres : parse_number n'échoue qu'en cas de dépassement
      int delay = std::min<uint32_t>(parse_number<uint32_t>(value).value_or(60000), 60000);
      int prev = mute_next_cmd_after_on_delay_;
      mute_next_cmd_after_on_delay_ = delay;
      mute_next_cmd_after_on_delay_pref_.save(&mute_next_cmd_after_on_delay_);
      publish_state();
      if (mute_next_cmd_after_on_delay_text_ != nullptr && prev != mute_next_cmd_after_on_delay_) {
        mute_next_cmd_after_on_delay_text_->publish_state(
          std::to_string(delay)
        );
      }
      ESP_LOGI(TAG, "Delay after on saved : %d", delay);
    }

    void ACW02::set_publish_stats_after_power_on_delay_string(const std::string &value) {
      if (value.empty() || !std::all_of(value.begin(), value.end(), ::isdigit)) {
        ESP_LOGI(TAG, "Invalid delay (non-numeric) : '%s'", value.c_str());
        publish_stats_after_power_on_delay_ = 0;
        return;
      }
      // value ne contient que des chiffres : parse_number n'échoue qu'en cas de dépassement
      int delay = std::min<uint32_t>(parse_number<uint32_t>(value).value_or(1000), 1000);
      int prev = publish_stats_after_power_on_delay_;
      publish_stats_after_power_on_delay_ = delay;
      publish_stats_after_power_on_delay_pref_.save(&publish_stats_after_power_on_delay_);
      publish_state();
      if (publish_stats_after_power_on_delay_text_ != nullptr && prev != publish_stats_after_power_on_delay_) {
        publish_stats_after_power_on_delay_text_->publish_state(
          std::to_string(delay)
        );
      }
      ESP_LOGI(TAG, "Delay publish after on saved : %d", delay);
    }

    
    void ACW02::set_g1_mqtt_options(bool on) {
      if (option_g1_mqtt_ != on) {
        option_g1_mqtt_ = on;
        option_G1_MQTT_pref_.save(&option_g1_mqtt_);
        publish_discovery_g1_mute_switch(true);
        publish_discovery_g1_option_recalculate_climate_switch(true);
        publish_discovery_g1_reset_eco_purifier_ac_off_switch(true);
        publish_discovery_disable_mode_auto_switch(true);
        publish_discovery_disable_mode_heat_switch(true);
        publish_discovery_disable_mode_dry_switch(true);
        publish_discovery_disable_mode_fan_switch(true);
        publish_discovery_disable_swing_vertical_switch(true);
        publish_discovery_disable_swing_horizontal_switch(true);
        publish_discovery_g1_mute_next_cmd_delay_text(true);
        publish_discovery_g1_mute_next_cmd_after_on_delay_text(true);
        publish_discovery_g1_publish_stats_after_power_on_delay_text(true);
        publish_discovery_g1_reload_button(true);
        publish_discovery_g1_rebuild_mqtt_entities_button(true);
        publish_discovery_g1_get_status_button(true);
        publish_discovery_z_config_validate_button(true);
        publish_discovery_mdns_text_sensor(true);
        publish_discovery_wifi_ip_text_sensor(true);
        publish_discovery_wifi_ssid_text_sensor(true);
        publish_discovery_wifi_bssid_text_sensor(true);
        publish_discovery_wifi_mac_text_sensor(true);
        publish_discovery_esp_version_text_sensor(true);
        publish_discovery_wifi_signal_text_sensor(true);
        publish_discovery_internal_temperature_text_sensor(true);
        publish_discovery_esp_memory_text_sensor(true);
      }
    }

    void ACW02::set_disable_mode_auto(bool on, bool published) {
      if (disable_mode_auto_ != on) {
        disable_mode_auto_ = on;
        disable_mode_auto_pref_.save(&disable_mode_auto_);
        if (published) {
          publish_state();
        }
      }
    }

    void ACW02::set_disable_mode_heat(bool on, bool published) {
      if (disable_mode_heat_ != on) {
        disable_mode_heat_ = on;
        disable_mode_heat_pref_.save(&disable_mode_heat_);
        if (published) {
          publish_state();
        }
      }
    }

    void ACW02::set_disable_mode_dry(bool on, bool published) {
      if (disable_mode_dry_ != on) {
        disable_mode_dry_ = on;
        disable_mode_dry_pref_.save(&disable_mode_dry_);
        if (published) {
          publish_state();
        }
      }
    }

    void ACW02::set_disable_mode_fan(bool on, bool published) {
      if (disable_mode_fan_ != on) {
        disable_mode_fan_ = on;
        disable_mode_fan_pref_.save(&disable_mode_fan_);
        if (published) {
          publish_state();
        }
      }
    }

    void ACW02::set_disable_swing_vertical(bool on, bool published) {
      if (disable_swing_vertical_ != on) {
        if (preset_ && !disable_swing_horizontal_ && !on) {
          set_disable_swing_horizontal(true, false);
        }
        disable_swing_vertical_ = on;
        disable_swing_vertical_pref_.save(&disable_swing_vertical_);
        if (published) {
          publish_state();
        }
      }
    }

    void ACW02::set_disable_swing_horizontal(bool on, bool published) {
      if (disable_swing_horizontal_ != on) {
        if (preset_ && !disable_swing_vertical_ && !on) {
          set_disable_swing_vertical(true, false);
        }
        disable_swing_horizontal_ = on;
        disable_swing_horizontal_pref_.save(&disable_swing_horizontal_);
        if (published) {
          publish_state();
        }
      }
    }

    void ACW02::entity_mdns_sync(const std::string &payload) {
      std::string tmpEntity = app_mdns_;
      app_mdns_ = payload;
      if (app_mdns_ != tmpEntity) {
        publish_state();
      }
    }

    void ACW02::entity_wifi_ip_sync(const std::string &payload) {
      std::string tmpEntity = app_wifi_ip_;
      app_wifi_ip_ = payload;
      if (app_wifi_ip_ != tmpEntity) {
        publish_state();
      }
    }

    void ACW02::entity_wifi_ssid_sync(const std::string &payload) {
      std::string tmpEntity = app_wifi_ssid_;
      app_wifi_ssid_ = payload;
      if (app_wifi_ssid_ != tmpEntity) {
        publish_state();
      }
    }

    void ACW02::entity_wifi_bssid_sync(const std::string &payload) {
      std::string tmpEntity = app_wifi_bssid_;
      app_wifi_bssid_ = payload;
      if (app_wifi_bssid_ != tmpEntity) {
        publish_state();
      }
    }

    void ACW02::entity_wifi_mac_sync(const std::string &payload) {
      std::string tmpEntity = app_wifi_mac_;
      app_wifi_mac_ = payload;
      if (app_wifi_mac_ != tmpEntity) {
        publish_state();
      }
    }

    void ACW02::entity_esp_version_sync(const std::string &payload) {
      std::string tmpEntity = app_esp_version_;
      app_esp_version_ = payload;
      if (app_esp_version_ != tmpEntity) {
        publish_state();
      }
    }

    void ACW02::entity_wifi_signal_sync(const std::string &payload) {
      std::string tmpEntity = app_wifi_signal_;
      app_wifi_signal_ = payload;
      if (app_wifi_signal_ != tmpEntity) {
        publish_state();
      }
    }

    void ACW02::entity_internal_temperature_sync(const std::string &payload) {
      std::string tmpEntity = app_internal_temperature_;
      std::string formatted = payload;
      std::replace(formatted.begin(), formatted.end(), '.', ',');
      app_internal_temperature_ = formatted;
      if (app_internal_temperature_ != tmpEntity) {
        publish_state();
      }
    }
    
    void ACW02::entity_esp_memory_sync(const std::string &payload) {
      std::string tmpEntity = app_esp_memory_;
      std::string formatted = payload;
      std::replace(formatted.begin(), formatted.end(), '.', ',');
      app_esp_memory_ = formatted;
      if (app_esp_memory_ != tmpEntity) {
        publish_state();
      }
    }

    void ACW02::set_preset(bool on, bool published) {
      if (preset_ != on) {
        if (on && !disable_swing_vertical_ && !disable_swing_horizontal_) {
          set_disable_swing_horizontal(true, false);
        }
        preset_ = on;
        preset_pref_.save(&preset_);
        publish_discovery_climate(true);
        if (published) {
          publish_state();
        }
      }
    }

    void ACW02::set_option_recalculate_climate(bool on) {
      if (option_recalculate_climate_ != on) {
        option_recalculate_climate_ = on;
        option_recalculate_climate_pref_.save(&option_recalculate_climate_);
        publish_discovery_climate(true);
        publish_state();
      }
    }

    void ACW02::set_mqtt_broker(const std::string &value) {
      mqtt_broker_address_ = value;
      char buf[64];
      std::strncpy(buf, value.c_str(), sizeof(buf));
      buf[sizeof(buf) - 1] = '\0';
      mqtt_broker_address_pref_.save((const char (*)[64]) &buf);
    }

    void ACW02::set_mqtt_username(const std::string &value) {
      mqtt_username_ = value;
      char buf[64];
      std::strncpy(buf, value.c_str(), sizeof(buf));
      buf[sizeof(buf) - 1] = '\0';
      mqtt_username_pref_.save((const char (*)[64]) &buf);
    }

    void ACW02::set_mqtt_password(const std::string &value) {
      mqtt_password_ = value;
      char buf[64];
      std::strncpy(buf, value.c_str(), sizeof(buf));
      buf[sizeof(buf) - 1] = '\0';
      mqtt_password_pref_.save((const char (*)[64]) &buf);
    }

    void ACW02::set_mqtt_port_from_string(const std::string &value) {
      if (value.empty() || !std::all_of(value.begin(), value.end(), ::isdigit)) {
        ESP_LOGI(TAG, "Invalid MQTT port (non-numeric) : '%s'", value.c_str());
        return;
      }

      int port = parse_number<uint16_t>(value).value_or(0);
      if (port < 1) {
        ESP_LOGI(TAG, "Invalid MQTT port (out of range) : '%s'", value.c_str());
        port = 1883;
      }

      mqtt_port_ = port;
      mqtt_port_pref_.save(&mqtt_port_);

      ESP_LOGI(TAG, "MQTT port saved : %d", port);
    }

    void ACW02::set_mqtt_connected_sensor(esphome::binary_sensor::BinarySensor *sensor) {
      mqtt_connected_sensor_ = sensor;
    }

    void ACW02::set_filter_dirty_sensor(binary_sensor::BinarySensor *sensor) {
      filter_dirty_sensor_ = sensor;
    }

    void ACW02::set_warn_sensor(binary_sensor::BinarySensor *sensor) {
      warn_sensor_ = sensor;
    }

    void ACW02::set_error_sensor(binary_sensor::BinarySensor *sensor) {
      error_sensor_ = sensor;
    }

    void ACW02::set_warn_text_sensor(esphome::text_sensor::TextSensor *sensor) {
      warn_text_sensor_ = sensor;
    }

    void ACW02::set_error_text_sensor(esphome::text_sensor::TextSensor *sensor) {
      error_text_sensor_ = sensor;
    }

    void ACW02::set_mute_next_cmd_delay_text(esphome::text::Text *text) {
      mute_next_cmd_delay_text_ = text;
    }

    void ACW02::set_mute_next_cmd_after_on_delay_text(esphome::text::Text *text) {
      mute_next_cmd_after_on_delay_text_ = text;
    }

    void ACW02::set_publish_stats_after_power_on_delay_text(esphome::text::Text *text) {
      publish_stats_after_power_on_delay_text_ = text;
    }

    void ACW02::reload_ac_info() {
      send_static_command_basic(get_status_frame_);
    }

    std::string ACW02::get_mac_address() {
      uint8_t mac[6];
      esp_read_mac(mac, ESP_MAC_WIFI_STA);
      char buf[13];
      snprintf(buf, sizeof(buf), "%02x%02x%02x%02x%02x%02x",
      mac[0], mac[1], mac[2], mac[3], mac[4], mac[5]);
      return std::string(buf);
    }

    std::string ACW02::get_address() {
      if (wifi::global_wifi_component != nullptr) {
        const char *address = wifi::global_wifi_component->get_use_address();

        if (address != nullptr && address[0] != '\0') {
          return std::string(address);
        }
      }

      return App.get_name() + ".local";
    }

    std::string ACW02::get_mode_string_climate() const {
      if (is_power_on()) {
        return mode_to_string_climate(mode_);
      } else {
        return "off";
      }
    }

    std::string ACW02::get_mode_string() const {
      if (is_power_on()) {
        return mode_to_string(app_lang_, mode_);
      } else {
        return key_to_txt(app_lang_, "mode", "OFF");
      }
    }

    std::string ACW02::get_fan_string() const {
      return fan_to_string(app_lang_, fan_);
    }

    std::string ACW02::get_swing_string() const {
      return swing_to_string(app_lang_, swing_position_);
    }

    std::string ACW02::get_unit() const {
      return use_fahrenheit_ ? "°F" : "°C";
    }

    float ACW02::get_target_temperature_c() const {
      return target_temp_c_;
    }

    float ACW02::get_target_temperature_f() const {
      return target_temp_f_;
    }

    bool ACW02::is_power_on() const {
      return power_on_;
    }

    bool ACW02::is_eco_on() const {
      return eco_;
    }

    bool ACW02::is_night_on() const {
      return night_;
    }

    bool ACW02::is_purifier_on() const {
      return purifier_;
    }

    bool ACW02::is_display_on() const {
      return display_;
    }

    bool ACW02::is_mute_on() const {
      return mute_;
    }

    bool ACW02::is_clean_on() const {
      return clean_;
    }

    bool ACW02::is_using_fahrenheit() const {
      return use_fahrenheit_;
    }

    bool ACW02::is_auto_off_options_when_ac_off() const {
      return auto_off_options_when_ac_off_;
    }

    int ACW02::get_mute_next_cmd_delay() const {
      return mute_next_cmd_delay_;
    }

    int ACW02::get_mute_next_cmd_after_on_delay() const {
      return mute_next_cmd_after_on_delay_;
    }

    int ACW02::get_publish_stats_after_power_on_delay() const {
      return publish_stats_after_power_on_delay_;
    }

    bool ACW02::is_g1_mqtt_options() const {
      return option_g1_mqtt_;
    }
    
    bool ACW02::is_disable_mode_auto() const {
      return disable_mode_auto_;
    }

    bool ACW02::is_disable_mode_heat() const {
      return disable_mode_heat_;
    }

    bool ACW02::is_disable_mode_dry() const {
      return disable_mode_dry_;
    }

    bool ACW02::is_disable_mode_fan() const {
      return disable_mode_fan_;
    }

    bool ACW02::is_disable_swing_vertical() const {
      return disable_swing_vertical_;
    }

    bool ACW02::is_disable_swing_horizontal() const {
      return disable_swing_horizontal_;
    }

    bool ACW02::is_option_recalculate_climate() const {
      return option_recalculate_climate_;
    }

    std::string ACW02::get_mqtt_broker() const {
      return mqtt_broker_address_;
    }

    std::string ACW02::get_mqtt_username() const {
      return mqtt_username_;
    }

    std::string ACW02::get_mqtt_password() const {
      return mqtt_password_;
    }

    int ACW02::get_mqtt_port() const {
      return mqtt_port_;
    }

    void ACW02::mqtt_connexion() {
      mqtt_ = mqtt::global_mqtt_client;
      mqtt_broker_address_pref_ = global_preferences->make_preference<char[64]>(9991U);
      char bufBroker[64] = {0};
      if (mqtt_broker_address_pref_.load((char (*)[64]) &bufBroker)) {
        mqtt_broker_address_ = bufBroker;
      } else {
        mqtt_broker_address_ = "";
      }

      mqtt_username_pref_ = global_preferences->make_preference<char[64]>(9992U);
      char bufUsername[64] = {0};
      if (mqtt_username_pref_.load((char (*)[64]) &bufUsername)) {
        mqtt_username_ = bufUsername;
      } else {
        mqtt_username_ = "";
      }

      mqtt_password_pref_ = global_preferences->make_preference<char[64]>(9993U);
      char bufPassword[64] = {0};
      if (mqtt_password_pref_.load((char (*)[64]) &bufPassword)) {
        mqtt_password_ = bufPassword;
      } else {
        mqtt_password_ = "";
      }

      mqtt_port_pref_ = global_preferences->make_preference<int>(9994U);
      if (!mqtt_port_pref_.load(&mqtt_port_)) {
        mqtt_port_ = 1883;
      }

      mqtt_->disable();
      mqtt_->set_enable_on_boot(false);
      mqtt_->set_broker_address(mqtt_broker_address_);
      mqtt_->set_broker_port(mqtt_port_);
      if (!mqtt_username_.empty())
      mqtt_->set_username(mqtt_username_);
      if (!mqtt_password_.empty())
      mqtt_->set_password(mqtt_password_);

      set_timeout("mqtt_connect", 2000, [this]() {
        if (wifi::global_wifi_component->is_connected()) {
          ESP_LOGW(TAG, "Wi-Fi OK; attempting MQTT connection…");
          mqtt_->enable();
          mqtt_initializer();
          // The code below is commented out because it can cause a bug with MQTT if it is stopped for a long time.
          // set_timeout("mqtt_retry", 5000, [this]() {
          //   if (!mqtt_->is_connected()) {
          //     mqtt_->disable();
          //   }
          // });
        } else {
          ESP_LOGW(TAG, "Wi-Fi not connected; retrying in 5 s");
          set_timeout("mqtt_retry", 2000, [this]() { mqtt_connexion(); });
        }
      });
    }

    void ACW02::mqtt_initializer() {
      if (mqtt_) {
        mqtt_->set_on_connect([this](bool first) {
          mqtt_publish_queue_.clear();
          ESP_LOGW(TAG, "MQTT connected → publishing discovery and state");
          if (mqtt_connected_sensor_) mqtt_connected_sensor_->publish_state(true);
          set_timeout("mqtt_discovery_delay", 100, [this]() {
            set_interval("mqtt_publish_flush", INTERVAL_MQTT_BETWEEN_CMD, [this]() {
              // The code below is commented out because it can cause a bug with MQTT if it is stopped for a long time.
              // if (!mqtt_ || !mqtt_->is_connected()) {
              //   ESP_LOGE(TAG, "mqtt_publish_flush return");
              //   return;
              // }
              if (!mqtt_ ) {
                return;
              }
              if (!mqtt_publish_queue_.empty()) {
                const auto &entry = mqtt_publish_queue_.front();
                ESP_LOGW(TAG, "mqtt_publish_queue_ publish to mqtt %s", entry.topic.c_str());
                mqtt_->publish(entry.topic, entry.payload, entry.qos, entry.retain);
                mqtt_publish_queue_.pop_front();
              }
              });
              this->set_interval("hb_last_seen", INTERVAL_INTERNAL_MQTT_KEEPALIVE, [this]() {
                // Get current UNIX time (epoch seconds)
                time_t now = ::time(nullptr);

                // Convert to string
                std::string payload = std::to_string(static_cast<long>(now));

                // Publish retained false, QoS 1
                publish_async(app_name_ + "/last_seen", payload, 1, false);

                ESP_LOGW(TAG, "Heartbeat last_seen published (epoch): %s", payload.c_str());
              });
              publish_discovery_climate();
              publish_discovery_mode_select();
              publish_discovery_fan_select();
              publish_discovery_swing_select();
              publish_discovery_swing_horizontal_select();
              publish_discovery_preset_select();
              publish_discovery_preset_config_select();
              publish_discovery_unit_select();
              publish_discovery_clean_switch();
              publish_discovery_eco_switch();
              publish_discovery_display_switch();
              publish_discovery_night_switch();
              publish_discovery_purifier_switch();
              publish_discovery_preset_switch();
              publish_discovery_preset_name_config_text();
              publish_discovery_temperature_number();
              publish_discovery_preset_save_button();
              publish_discovery_preset_delete_button();
              publish_discovery_temperature_sensor();
              publish_discovery_last_cmd_origin_sensor();
              publish_discovery_filter_dirty_sensor();
              publish_discovery_warn_sensor();
              publish_discovery_error_sensor();
              publish_discovery_cmd_failure_counter_sensor();
              publish_discovery_warn_text_sensor();
              publish_discovery_error_text_sensor();
              if (option_g1_mqtt_) {
                set_timeout("publish_discovery_option_g1_mqtt_recreate", DELAY_MQTT_G1_GENERATE, [this]() {
                  publish_discovery_g1_mute_switch();
                  publish_discovery_g1_option_recalculate_climate_switch();
                  publish_discovery_g1_reset_eco_purifier_ac_off_switch();
                  publish_discovery_disable_mode_auto_switch();
                  publish_discovery_disable_mode_heat_switch();
                  publish_discovery_disable_mode_dry_switch();
                  publish_discovery_disable_mode_fan_switch();
                  publish_discovery_disable_swing_vertical_switch();
                  publish_discovery_disable_swing_horizontal_switch();
                  publish_discovery_g1_mute_next_cmd_delay_text();
                  publish_discovery_g1_mute_next_cmd_after_on_delay_text();
                  publish_discovery_g1_publish_stats_after_power_on_delay_text();
                  publish_discovery_g1_reload_button();
                  publish_discovery_g1_rebuild_mqtt_entities_button();
                  publish_discovery_g1_get_status_button();
                  publish_discovery_z_config_validate_button();
                  publish_discovery_mdns_text_sensor();
                  publish_discovery_wifi_ip_text_sensor();
                  publish_discovery_wifi_ssid_text_sensor();
                  publish_discovery_wifi_bssid_text_sensor();
                  publish_discovery_wifi_mac_text_sensor();
                  publish_discovery_esp_version_text_sensor();
                  publish_discovery_wifi_signal_text_sensor();
                  publish_discovery_internal_temperature_text_sensor();
                  publish_discovery_esp_memory_text_sensor();
                });
              }
              send_static_command_basic(get_status_frame_);
            });
            mqtt_->subscribe(app_name_ + "/cmd/#", [this](const std::string &topic, const std::string &payload) {
              mqtt_callback(topic, payload);
            }, 1);
            mqtt_->subscribe(app_name_ + "/cmd_ac/#", [this](const std::string &topic, const std::string &payload) {
              mqtt_callback(topic, payload);
            }, 1);
            mqtt_->subscribe(app_name_ + "/ping/request", [this](const std::string &topic, const std::string &payload) {
              ESP_LOGW(TAG, "Ping request received: %s", payload.c_str());
              this->set_timeout("delayed_ping_response", 200, [this, payload]() {
                publish_async(app_name_ + "/ping/response", payload, 1, false);
              });
            }, 1);
            // for generate failed compare fingerprint
            // set_interval("test", 500, [this]() {
            //   write_array(get_status_frame_);
            // });
        });
        mqtt_->set_on_disconnect([this](mqtt::MQTTClientDisconnectReason reason) {
          ESP_LOGW(TAG, "MQTT disconnected (reason=%d)", static_cast<int>(reason));
          if (mqtt_connected_sensor_) mqtt_connected_sensor_->publish_state(false);
          this->cancel_interval("mqtt_publish_flush");
          this->cancel_interval("hb_last_seen");
          this->cancel_timeout("mqtt_discovery_delay");
          ack_wait_ = false;
          ack_block_until_ = 0;
          timeout_retry_pending_ = false;
          cmd_send_fingerprint_ = {0, "", {}, 0, 0};
        });
      }
    }

    void ACW02::mqtt_callback(const std::string &topic, const std::string &payload) {
      ESP_LOGW(TAG, "mqtt_callback =====>>>> start !");
      std::string cmd = topic.substr(topic.find_last_of('/') + 1);

      // --- Gestion des nouveaux topics individuels pour chaque mode ---
      // mode_climate est la commande native du climate HA, à ne pas intercepter ici
      if (topic.find("/cmd_ac/") != std::string::npos && cmd.compare(0, 5, "mode_") == 0 && cmd != "mode_climate") {
        std::string mode_key = cmd.substr(5);
        std::transform(mode_key.begin(), mode_key.end(), mode_key.begin(), ::toupper);

        ESP_LOGW(TAG, "MQTT individual mode command received: %s (payload: %s)", mode_key.c_str(), payload.c_str());

        if (payload == "OFF" || payload == "0") {
          ESP_LOGI(TAG, "Ignoring OFF payload for mode command: %s", mode_key.c_str());
          return;
        }

        std::string mode_value;
        if (mode_key == "OFF")
          mode_value = "off";
        else if (mode_key == "AUTO")
          mode_value = "auto";
        else if (mode_key == "COOL")
          mode_value = "cool";
        else if (mode_key == "DRY")
          mode_value = "dry";
        else if (mode_key == "HEAT")
          mode_value = "heat";
        else if (mode_key == "FAN")
          mode_value = "fan_only";
        else {
          ESP_LOGE(TAG, "Unknown individual mode command: %s", mode_key.c_str());
          return;
        }

        // On appelle la logique complète de traitement comme une commande climate native (indépendante de la langue)
        std::string simulated_topic = app_name_ + "/cmd_ac/mode_climate";
        mqtt_callback(simulated_topic, mode_value);
        return;
      }

      if (topic.find("/cmd_ac/") != std::string::npos) {
        ESP_LOGW(TAG, "mqtt_callback cmd type cmd_ac !");
      }

      //calc start fingerprint
      bool tmp_send_cmd = false;
      uint32_t start_f = ac_to_fingerprint();
      bool prev_power_status = is_power_on();
      bool isDisplayCmd = false;
      bool was_power = power_on_;
      Mode was_mode = mode_;

      ESP_LOGW(TAG, "mqtt_callback_ payload %s %s %s", cmd.c_str(), topic.c_str(), payload.c_str());
      ESP_LOGW(TAG, "mqtt_callback_ status %s %s", power_on_ ? "on" : "off",  mode_to_string_climate(mode_).c_str());
      if (cmd == "power_climate") {
        set_mode_climate(payload == "OFF" ? "off" : mode_to_string_climate(mode_));
        tmp_send_cmd = true;
      } else if (cmd == "power") {
        set_mode(payload == key_to_txt(app_lang_, "mode", "OFF") ? key_to_txt(app_lang_, "mode", "OFF") : mode_to_string(app_lang_, mode_));
        tmp_send_cmd = true;
      } else if (cmd == "mode_climate") {
        ESP_LOGW(TAG, "mqtt_callback_ set_mode_climate");
        set_mode_climate(payload);
        tmp_send_cmd = true;
      } else if (cmd == "mode") {
        set_mode(payload);
        tmp_send_cmd = true;
      } else if (cmd == "fan") {
        tmp_send_cmd = set_fan(payload);
      } else if (cmd == "temp_c" || cmd == "temp_f") {
        optional<float> temp = parse_number<float>(payload);
        if (!temp.has_value() || std::isnan(*temp)) {
          ESP_LOGW(TAG, "Invalid temperature payload: '%s'", payload.c_str());
        } else if (cmd == "temp_c") {
          tmp_send_cmd = set_temperature_c(*temp);
        } else {
          tmp_send_cmd = set_temperature_f(*temp);
        }
      } else if (cmd == "eco") {
        tmp_send_cmd = set_eco(payload == "on");
      } else if (cmd == "night") {
        tmp_send_cmd = set_night(payload == "on");
      } else if (cmd == "purifier") {
        set_purifier(payload == "on");
        tmp_send_cmd = true;
      } else if (cmd == "display") {
        tmp_send_cmd = set_display(payload == "on");
        isDisplayCmd = true;
      } else if (cmd == "swing") {
        set_swing(payload);
        tmp_send_cmd = true;
      }  else if (cmd == "swing_horizontal") {
        set_swing_horizontal(payload);
        tmp_send_cmd = true;
      } else if (cmd == "clean") {
        set_clean(payload == "on");
      } else if (cmd == "unit") {
        set_unit(payload);
        tmp_send_cmd = true;
      } else if (cmd == "g1_mute") {
        set_mute(payload == "on" ? true : false);
      } else if (cmd == "g1_reset_eco_purifier") {
        set_auto_off_options_when_ac_off(payload == "on" ? true : false);
      } else if (cmd == "g1_option_recalculate_climate") {
        set_option_recalculate_climate(payload == "on" ? true : false);
      } else if (cmd == "g1_restart_module_ac") {
        esphome::App.safe_reboot();
      } else if (cmd == "g1_rebuild_mqtt_entities") {
        rebuild_mqtt_entity();
      } else if (cmd == "g1_get_status") {
        reload_ac_info();
      } else if (cmd == "g1_mute_next_cmd_delay") {
        set_mute_next_cmd_delay_string(payload);
      } else if (cmd == "g1_mute_next_cmd_after_on_delay") {
        set_mute_next_cmd_after_on_delay_string(payload);
      } else if (cmd == "g1_publish_stats_after_power_on_delay") {
        set_publish_stats_after_power_on_delay_string(payload);
      } else if (cmd == "disable_mode_auto") {
        set_disable_mode_auto(payload == "on" ? true : false, false);
      } else if (cmd == "disable_mode_heat") {
        set_disable_mode_heat(payload == "on" ? true : false, false);
      } else if (cmd == "disable_mode_dry") {
        set_disable_mode_dry(payload == "on" ? true : false, false);
      } else if (cmd == "disable_mode_fan") {
        set_disable_mode_fan(payload == "on" ? true : false, false);
      } else if (cmd == "disable_swing_vertical") {
        set_disable_swing_vertical(payload == "on" ? true : false, false);
      } else if (cmd == "disable_swing_horizontal") {
        set_disable_swing_horizontal(payload == "on" ? true : false, false);
      } else if (cmd == "z_config_validate") {
        apply_disable_settings();
      } else if (cmd == "preset") {
        set_preset(payload == "on" ? true : false, false);
      } else if (cmd == "presets_list_element_config") {
        presets_list_element_config_ = payload;
        PresetSlot preset = get_preset_by_name(presets_list_element_config_);

        if (!preset.name.empty()) {
          ESP_LOGI(TAG, "Preset %d frame found with %d octets", preset.index, preset.frame_with_fp.frame.size());
          ESP_LOGW(TAG, "Preset \"%s\" frame: %s fingerprint: 0x%08" PRIX32, preset.name.c_str(), format_hex_pretty(preset.frame_with_fp.frame).c_str(), preset.frame_with_fp.fingerprint);
          size_t pos = preset.name.find(" (empty)");
          if (pos != std::string::npos) {
            preset.name = "Preset";
          }
          if (preset.name.length() >= 2 && std::isdigit(preset.name[0]) && preset.name[1] == ' ') {
            preset.name = preset.name.substr(2);
          }
          preset_name_config_ = preset.name;
        } else {
          preset_name_config_ = "";
        }
      } else if (cmd == "presets_list_element") {
        presets_list_element_ = payload;
        if (payload == "none") {
          presets_list_element_ = get_localized_name(app_lang_, "presetNone");
        } else {
          presets_list_element_ = payload;
        }
        PresetSlot preset = get_preset_by_name(presets_list_element_);
        if (preset.name != get_localized_name(app_lang_, "presetNone")) {
          preset.frame_with_fp.timestamp_ms = millis();
          send_command_basic(preset.frame_with_fp);
        }
      } else if (cmd == "preset_save") {
        update_selected_preset(preset_name_config_, build_frame());
        preset_name_config_ = "";
        presets_list_element_ = get_localized_name(app_lang_, "presetNone");
      } else if (cmd == "preset_delete") {
        delete_preset_by_name();
        preset_name_config_ = "";
        presets_list_element_ = get_localized_name(app_lang_, "presetNone");
      } else if (cmd == "preset_name_config") {
        if (payload.size() > 22) {
            preset_name_config_ = payload.substr(0, 22);
        } else {
          preset_name_config_ = payload;
        }
      }

      bool after_power_status = is_power_on();
      uint32_t end_f = ac_to_fingerprint();
      bool changed = !compare_fingerprints(start_f, end_f);

      ESP_LOGW(TAG,
        "DECIDE cmd=%s fp_start=0x%08" PRIX32
        " fp_end=0x%08" PRIX32
        " changed=%d | before{pwr=%d,mode=%d,temp_enc=%u} after{pwr=%d,mode=%d,temp_enc=%u}",
        cmd.c_str(), start_f, end_f, (int)changed,
        (int)was_power, (int)was_mode, (unsigned)encode_temperature_byte(),
        (int)power_on_, (int)mode_, (unsigned)encode_temperature_byte());

      ESP_LOGW(TAG,"mqtt_callback_ compare_fingerprints 0x%08" PRIX32 " 0x%08" PRIX32, start_f, end_f);
      if (tmp_send_cmd && changed) {
        ESP_LOGW(TAG, "mqtt_callback_ send_command");
        send_command(isDisplayCmd);
        presets_list_element_ = get_localized_name(app_lang_, "presetNone");
        if (mute_next_cmd_after_on_delay_ > 0 && !prev_power_status && after_power_status) {
          mute_tmp_mqtt_ = true;
          this->set_timeout("mute_tmp_after_on", mute_next_cmd_after_on_delay_, [this]() {
            mute_tmp_mqtt_ = false;
          });
        } else if (mute_next_cmd_delay_ > 0) {
          mute_tmp_mqtt_ = true;
          this->set_timeout("mute_tmp", mute_next_cmd_delay_, [this]() {
            mute_tmp_mqtt_ = false;
          });
        }
      }
      if (publish_stats_after_power_on_delay_ > 0 && !prev_power_status && after_power_status) {
        time_publish_stats_after_power_on_ = millis() + publish_stats_after_power_on_delay_;
      }
      publish_state();
      ESP_LOGW(TAG, "mqtt_callback =====>>>> end !");
    }

    void ACW02::publish_state() {
      if (!mqtt_) {
        ESP_LOGE(TAG, "publish_state =====>>>> mqtt_ is false");
        return;
      }

      if (publish_stats_after_power_on_delay_ > 0 && time_publish_stats_after_power_on_ > 0 && time_publish_stats_after_power_on_ > millis()) {
         set_timeout("publish_state_after_on", 100, [this]() {
          publish_state();
        });
        return;
      }
      time_publish_stats_after_power_on_ = 0;

      std::string payload = "{";
      payload += "\"power_climate\":\"" + std::string(power_on_ ? "on" : "off") + "\",";
      payload += "\"power\":\"" + std::string(power_on_ ? "on" : "off") + "\",";
      payload += "\"mode_climate\":\"" + get_mode_string_climate() + "\",";
      payload += "\"mode\":\"" + get_mode_string() + "\",";
      payload += "\"fan\":\"" + fan_to_string(app_lang_, fan_) + "\",";
      payload += "\"temp_c\":" + std::to_string(target_temp_c_) + ",";
      payload += "\"temp_f\":" + std::to_string(target_temp_f_) + ",";
      payload += "\"ambient_c\":" + std::to_string(ambient_temp_c_) + ",";
      payload += "\"ambient_f\":" + std::to_string(ambient_temp_f_) + ",";
      payload += "\"eco\":\"" + std::string(eco_ ? "on" : "off") + "\",";
      payload += "\"night\":\"" + std::string(night_ ? "on" : "off") + "\",";
      payload += "\"clean\":\"" + std::string(clean_ ? "on" : "off") + "\",";
      payload += "\"purifier\":\"" + std::string(purifier_ ? "on" : "off") + "\",";
      payload += "\"display\":\"" + std::string(display_ ? "on" : "off") + "\",";
      payload += "\"swing\":\"" + swing_to_string(app_lang_, swing_position_) + "\",";
      std::string swingH = swing_horizontal_to_string(app_lang_, swing_horizontal_);
      payload += "\"swing_horizontal\":\"" + swingH + "\",";
      if (swingH == key_to_txt(app_lang_, "swingHorizontal", "STOP")) {
        swingH = "none";
      }
      payload += "\"swing_horizontal_climate\":\"" + swingH + "\",";
      payload += "\"unit\":\"" + std::string(use_fahrenheit_ ? "°F" : "°C") + "\",";
      payload += "\"last_cmd_origin\":\"" + std::string(from_remote_ ? "Remote" : "ESP") + "\",";
      payload += "\"filter_dirty\":\"" + std::string(filter_dirty_ ? "true" : "false") + "\",";
      payload += "\"warn\":\"" + std::string(warn_ ? "true" : "false") + "\",";
      payload += "\"error\":\"" + std::string(error_ ? "true" : "false") + "\",";
      payload += "\"warn_text\":\"" + warn_text_ + "\",";
      payload += "\"error_text\":\"" + error_text_ + "\",";
      payload += "\"g1_mute\":\"" + std::string(mute_ ? "on" : "off") + "\",";
      payload += "\"g1_mute_next_cmd_delay\":" + int_to_string(mute_next_cmd_delay_) + ",";
      payload += "\"g1_mute_next_cmd_after_on_delay\":" + int_to_string(mute_next_cmd_after_on_delay_) + ",";
      payload += "\"g1_publish_stats_after_power_on_delay\":" + int_to_string(publish_stats_after_power_on_delay_) + ",";
      payload += "\"g1_reset_eco_purifier\":\"" + std::string(auto_off_options_when_ac_off_ ? "on" : "off") + "\",";
      payload += "\"g1_option_recalculate_climate\":\"" + std::string(option_recalculate_climate_ ? "on" : "off") + "\",";
      payload += "\"disable_mode_auto\":\"" + std::string(disable_mode_auto_ ? "on" : "off") + "\",";
      payload += "\"disable_mode_heat\":\"" + std::string(disable_mode_heat_ ? "on" : "off") + "\",";
      payload += "\"disable_mode_dry\":\"" + std::string(disable_mode_dry_ ? "on" : "off") + "\",";
      payload += "\"disable_mode_fan\":\"" + std::string(disable_mode_fan_ ? "on" : "off") + "\",";
      payload += "\"disable_swing_vertical\":\"" + std::string(disable_swing_vertical_ ? "on" : "off") + "\",";
      payload += "\"disable_swing_horizontal\":\"" + std::string(disable_swing_horizontal_ ? "on" : "off") + "\",";
      payload += "\"mdns\":\""  + app_mdns_ + "\",";
      payload += "\"wifi_ip\":\""  + app_wifi_ip_ + "\",";
      payload += "\"wifi_ssid\":\""  + app_wifi_ssid_ + "\",";
      payload += "\"wifi_bssid\":\""  + app_wifi_bssid_ + "\",";
      payload += "\"wifi_mac\":\""  + app_wifi_mac_ + "\",";
      payload += "\"esp_version\":\""  + app_esp_version_ + "\",";
      payload += "\"wifi_signal\":\""  + app_wifi_signal_ + " dBm\",";
      payload += "\"internal_temperature\":\""  + app_internal_temperature_ + " °C\",";
      payload += "\"esp_memory\":\""  + app_esp_memory_ + " kB\",";
      payload += "\"preset\":\"" + std::string(preset_ ? "on" : "off") + "\",";
      payload += "\"presets_list_element_config\":\"" + presets_list_element_config_ + "\",";
      payload += "\"presets_list_element\":\"" + presets_list_element_ + "\",";
      std::string presets_list_element_climate = presets_list_element_;
      if (presets_list_element_climate == get_localized_name(app_lang_, "presetNone")) {
        presets_list_element_climate = "none";
      }
      payload += "\"presets_list_element_climate\":\"" + presets_list_element_climate + "\",";
      payload += "\"preset_name_config\":\"" + preset_name_config_ + "\",";
      payload += "\"cmd_failure_counter\":\"" + std::to_string(cmd_failure_counter_) + "\"";
      payload += "}";
      ESP_LOGW(TAG, "publish_state send");
      publish_async(app_name_ + "/state", payload, 1, true);
    }

    void ACW02::publish_availability() {
      if (!mqtt_) return;

      const std::string topic_eco = app_name_ + "/eco_availability";
      std::string payload_eco = (power_on_ && mode_ == Mode::COOL) ? "available" : "unavailable";
      publish_async(topic_eco, payload_eco, 1, true);

      const std::string topic_night = app_name_ + "/night_availability";
      std::string payload_night = (power_on_ && (mode_ == Mode::COOL || mode_ == Mode::DRY || mode_ == Mode::HEAT)) ? "available" : "unavailable";
      publish_async(topic_night, payload_night, 1, true);

      const std::string topic_fan_speed = app_name_ + "/fan_speed_availability";
      std::string payload_fan_speed = (eco_ == false || !power_on_) ? "available" : "unavailable";
      publish_async(topic_fan_speed, payload_fan_speed, 1, true);

      const std::string topic_target_temp = app_name_ + "/target_temp_availability";
      std::string payload_target_temp = ((mode_ != Mode::AUTO && eco_ == false) || !power_on_) ? "available" : "unavailable";
      publish_async(topic_target_temp, payload_target_temp, 1, true);

      const std::string topic_purifier = app_name_ + "/purifier_availability";
      std::string payload_purifier = (power_on_) ? "available" : "unavailable";
      publish_async(topic_purifier, payload_purifier, 1, true);

      const std::string topic_clean = app_name_ + "/clean_availability";
      std::string payload_clean = (!power_on_) ? "available" : "unavailable";
      publish_async(topic_clean, payload_clean, 1, true);
    }

    std::string ACW02::build_common_config_suffix() const {
      return R"(
      ,"qos": 1
      ,"dev": {
        "ids": [")" + app_sanitize_name_ + R"("],
        "name": ")" + app_friendly_name_ + R"(",
        "mdl": ")" + app_board_ + R"(",
        "mf": "Espressif",
        "cns": [["mac",")" + app_mac_ + R"("]]
      })";
    }

    void ACW02::publish_discovery_climate_deref() {
      set_timeout("publish_discovery_climate_deref", 100, [this]() {
        publish_discovery_climate();
      });
    }

    void ACW02::publish_discovery_climate(bool recreate) {
      if (!mqtt_) return;

      const std::string topic_base = app_name_;
      const std::string unique_id = app_sanitize_name_ + "_mqtt_climate";

      const std::string temp_suffix = use_fahrenheit_ ? "_f" : "_c";

      std::string mintemp = use_fahrenheit_ ? "61" : "16";
      std::string maxtemp = use_fahrenheit_ ? "88" : "31";

      if (power_on_ && mode_ == Mode::AUTO) {
        auto_temp_defined_heat_cool_calculator();
      }

      if (power_on_ && (eco_ || mode_ == Mode::AUTO)) {
        mintemp = use_fahrenheit_ ? std::to_string(target_temp_f_) : std::to_string(target_temp_c_);
        maxtemp = mintemp;
      }
      
      
      std::string payload = R"({
        "name": ")" + get_localized_name(app_lang_, "climate") + R"(",
        "default_entity_id": ")" + "climate." + unique_id + R"(",
        "unique_id": ")" + unique_id + R"(",
        "stat_t": ")" + topic_base + R"(/state",
        "cmd_t": ")" + topic_base + R"(/cmd_ac/mode_climate",)";
        if (!disable_swing_vertical_ && !disable_swing_horizontal_) {
          payload += R"(
          "preset_mode_command_topic": ")" + topic_base + R"(/cmd_ac/swing_horizontal",
          "preset_mode_state_topic": ")" + topic_base + R"(/state",
          "preset_mode_value_template": "{{ value_json.swing_horizontal_climate }}",
          "preset_modes": )" + build_options_json(app_lang_, "swingHorizontal", "STOP") + R"(,)";
        } else if (preset_) {
          payload += R"(
          "preset_mode_command_topic": ")" + topic_base + R"(/cmd_ac/presets_list_element",
          "preset_mode_state_topic": ")" + topic_base + R"(/state",
          "preset_mode_value_template": "{{ value_json.presets_list_element_climate }}",
          "preset_modes": )" + get_preset_list(true, true) + R"(,)";
        }
        payload += R"(
        "mode_stat_t": ")" + topic_base + R"(/state",
        "mode_stat_tpl": "{{ value_json.mode_climate }}",
        "mode_cmd_t": ")" + topic_base + R"(/cmd_ac/mode_climate",
        "modes": )" + build_modes_json_climate() + R"(,
        "temp_cmd_t": ")" + topic_base + "/cmd_ac/temp" + temp_suffix + R"(",
        "temp_stat_t": ")" + topic_base + R"(/state",
        "temp_stat_tpl": "{{ value_json.temp)" + temp_suffix + R"( }}",
        "curr_temp_t": ")" + topic_base + R"(/state",
        "curr_temp_tpl": "{{ value_json.ambient)" + temp_suffix + R"( }}",
        "fan_mode_cmd_t": ")" + topic_base + R"(/cmd_ac/fan",
        "fan_mode_stat_t": ")" + topic_base + R"(/state",
        "fan_mode_stat_tpl": "{{ value_json.fan }}",
        "fan_modes": )" + build_fan_speed_json() + R"(,)";
        
        if (!disable_swing_vertical_ && !disable_swing_horizontal_) {
          payload += R"(
          "swing_mode_cmd_t": ")" + topic_base + R"(/cmd_ac/swing",
          "swing_mode_stat_t": ")" + topic_base + R"(/state",
          "swing_mode_stat_tpl": "{{ value_json.swing }}",
          "swing_modes": )" + build_options_json(app_lang_, "swing") + R"(,)";
        } else {
          if (disable_swing_vertical_ && !disable_swing_horizontal_) {
             payload += R"(
            "swing_mode_cmd_t": ")" + topic_base + R"(/cmd_ac/swing_horizontal",
            "swing_mode_stat_t": ")" + topic_base + R"(/state",
            "swing_mode_stat_tpl": "{{ value_json.swing_horizontal }}",
            "swing_modes": )" + build_options_json(app_lang_, "swingHorizontal") + R"(,)";
          } else if (disable_swing_horizontal_ && !disable_swing_vertical_) {
             payload += R"(
            "swing_mode_cmd_t": ")" + topic_base + R"(/cmd_ac/swing",
            "swing_mode_stat_t": ")" + topic_base + R"(/state",
            "swing_mode_stat_tpl": "{{ value_json.swing }}",
            "swing_modes": )" + build_options_json(app_lang_, "swing") + R"(,)";
          }
        }
        payload += R"(
        "pow_cmd_t": ")" + topic_base + R"(/cmd_ac/power_climate",
        "pow_stat_t": ")" + topic_base + R"(/state",
        "pow_stat_tpl": "{{ value_json.power_climate }}",
        "min_temp": )" + (mintemp) + R"(,
        "max_temp": )" + (maxtemp) + R"(,
        "temp_step": 1,
        "avty_t":")" + topic_base + R"(/status")" +
        build_common_config_suffix() + R"(
      })";

      std::string config_topic = "homeassistant/climate/" + topic_base + "/config";
      if (recreate) {
        publish_async(config_topic, std::string(""), 1, true);
        set_timeout("mqtt_publish_discovery_climate_publish", mqtt_delay_rebuild_short_, [this, config_topic, payload]() {
          publish_async(config_topic, payload, 1, true);
        });
      } else {
        publish_async(config_topic, payload, 1, true);
      }
    }

    void ACW02::publish_discovery_mode_select(bool recreate) {
      if (!mqtt_)
        return;

      const std::string topic_base = app_name_;
      const std::string unique_id = app_sanitize_name_ + "_mqtt_mode";

      // Sélecteur principal
      std::string config_topic = "homeassistant/select/" + topic_base + "-mode/config";
      std::string payload = R"({
        "name": ")" + get_localized_name(app_lang_, "mode") + R"(",
        "default_entity_id": ")" + "select." + unique_id + R"(",
        "unique_id": ")" + unique_id + R"(",
        "icon": "mdi:thermostat",
        "cmd_t": ")" + topic_base + R"(/cmd_ac/mode",
        "stat_t": ")" + topic_base + R"(/state",
        "val_tpl": "{{ value_json.mode }}",
        "options": )" + build_modes_json() + R"(,
        "avty_t": ")" + topic_base + R"(/status",
        "pl_avail": "online",
        "pl_not_avail": "offline")" +
        build_common_config_suffix() + R"(
      })";

      if (recreate) {
        publish_async(config_topic, std::string(""), 1, true);
        set_timeout("mqtt_publish_discovery_mode_select_publish", mqtt_delay_rebuild_, [this, config_topic, payload]() {
          publish_async(config_topic, payload, 1, true);
        });
      } else {
        publish_async(config_topic, payload, 1, true);
      }

      // --- Nouvelle section : publication de boutons individuels pour chaque mode ---
      const auto &mode_dict = LOCALIZED.at(app_lang_).at("mode");

      for (const auto &it : mode_dict) {
        const std::string &key = it.first;
        const std::string &label = it.second;

        // On respecte les conditions de disponibilité
        if ((key == "AUTO" && is_disable_mode_auto()) ||
            (key == "DRY" && is_disable_mode_dry()) ||
            (key == "HEAT" && is_disable_mode_heat()) ||
            (key == "FAN" && is_disable_mode_fan()))
          continue;

        const std::string button_unique_id = app_sanitize_name_ + "_mqtt_mode_" + sanitize_name(key);
        std::string button_config_topic = "homeassistant/button/" + topic_base + "-mode-" + sanitize_name(key) + "/config";

        std::string button_payload = R"({
          "name": ")" + label + R"(",
          "default_entity_id": ")" + "button." + button_unique_id + R"(",
          "unique_id": ")" + button_unique_id + R"(",
          "icon": "mdi:thermostat",
          "cmd_t": ")" + topic_base + R"(/cmd_ac/mode_)" + sanitize_name(key) + R"(",
          "entity_category": "config",
          "avty_t": ")" + topic_base + R"(/status",
          "pl_avail": "online",
          "pl_not_avail": "offline")" +
          build_common_config_suffix() + R"(
        })";

        if (recreate) {
          publish_async(button_config_topic, std::string(""), 1, true);
          // ESPHome >= 2026.7 : un nom de timeout dynamique doit passer par un id numérique
          set_timeout(fnv1a_hash("mqtt_publish_discovery_mode_button_" + sanitize_name(key)),
                      mqtt_delay_rebuild_,
                      [this, button_config_topic, button_payload]() {
                        publish_async(button_config_topic, button_payload, 1, true);
                      });
        } else {
          publish_async(button_config_topic, button_payload, 1, true);
        }
      }
    }


    void ACW02::publish_discovery_fan_select(bool recreate) {
      if (!mqtt_)
      return;

      const std::string topic_base = app_name_;
      const std::string unique_id = app_sanitize_name_ + "_mqtt_fan";

      std::string config_topic = "homeassistant/select/" + topic_base + "-fan/config";

      std::string payload = R"({
        "name": ")" + get_localized_name(app_lang_, "fan") + R"(",
        "default_entity_id": ")" + "select." + unique_id + R"(",
        "unique_id": ")" + unique_id + R"(",
        "icon": "mdi:fan",
        "cmd_t": ")" + topic_base + R"(/cmd_ac/fan",
        "stat_t": ")" + topic_base + R"(/state",
        "val_tpl": "{{ value_json.fan }}",
        "options": )" + build_options_json(app_lang_, "fan") + R"(,
        "availability_mode": "all",
        "availability": [
        {
          "topic": ")" + topic_base + R"(/status",
          "payload_available": "online",
          "payload_not_available": "offline"
        },
        {
          "topic": ")" + topic_base + R"(/fan_speed_availability",
          "payload_available": "available",
          "payload_not_available": "unavailable"
        }
        ])" +
        build_common_config_suffix() + R"(
      })";

      if (recreate) {
        publish_async(config_topic, std::string(""), 1, true);
        set_timeout("mqtt_publish_discovery_fan_select_publish", mqtt_delay_rebuild_, [this, config_topic, payload]() {
          publish_async(config_topic, payload, 1, true);
        });
      } else {
        publish_async(config_topic, payload, 1, true);
      }
    }

    void ACW02::publish_discovery_unit_select(bool recreate) {
      if (!mqtt_)
      return;

      const std::string topic_base = app_name_;
      const std::string unique_id = app_sanitize_name_ + "_mqtt_unit";

      std::string config_topic = "homeassistant/select/" + topic_base + "-unit/config";

      std::string payload = R"({
        "name": ")" + get_localized_name(app_lang_, "unit") + R"(",
        "default_entity_id": ")" + "select." + unique_id + R"(",
        "unique_id": ")" + unique_id + R"(",
        "cmd_t": ")" + topic_base + R"(/cmd_ac/unit",
        "stat_t": ")" + topic_base + R"(/state",
        "val_tpl": "{{ value_json.unit }}",
        "options": ["°C", "°F"],
        "avty_t": ")" + topic_base + R"(/status",
        "pl_avail": "online",
        "pl_not_avail": "offline")" +
        build_common_config_suffix() + R"(
      })";

      if (recreate) {
        publish_async(config_topic, std::string(""), 1, true);
        set_timeout("mqtt_publish_discovery_unit_select_publish", mqtt_delay_rebuild_, [this, config_topic, payload]() {
          publish_async(config_topic, payload, 1, true);
        });
      } else {
        publish_async(config_topic, payload, 1, true);
      }
    }

    void ACW02::publish_discovery_swing_select(bool recreate) {
      if (!mqtt_)
      return;

      const std::string topic_base = app_name_;
      const std::string unique_id = app_sanitize_name_ + "_mqtt_swing";

      std::string config_topic = "homeassistant/select/" + topic_base + "-swing/config";

      std::string payload = R"({
        "name": ")" + get_localized_name(app_lang_, "swing") + R"(",
        "default_entity_id": ")" + "select." + unique_id + R"(",
        "unique_id": ")" + unique_id + R"(",
        "icon": "mdi:swap-vertical",
        "cmd_t": ")" + topic_base + R"(/cmd_ac/swing",
        "stat_t": ")" + topic_base + R"(/state",
        "val_tpl": "{{ value_json.swing }}",
        "options": )" + build_options_json(app_lang_, "swing") + R"(,
        "avty_t": ")" + topic_base + R"(/status",
        "pl_avail": "online",
        "pl_not_avail": "offline")" +
        build_common_config_suffix() + R"(
      })";

      if (recreate) {
        publish_async(config_topic, std::string(""), 1, true);
        set_timeout("mqtt_publish_discovery_swing_select_publish", mqtt_delay_rebuild_, [this, config_topic, payload]() {
          publish_async(config_topic, payload, 1, true);
        });
      } else {
        publish_async(config_topic, payload, 1, true);
      }
    }

    void ACW02::publish_discovery_swing_horizontal_select(bool recreate) {
      if (!mqtt_)
      return;

      const std::string topic_base = app_name_;
      const std::string unique_id = app_sanitize_name_ + "_mqtt_swing_horizontal";

      std::string config_topic = "homeassistant/select/" + topic_base + "-swing-horizontal/config";

      std::string payload = R"({
        "name": ")" + get_localized_name(app_lang_, "swingHorizontal") + R"(",
        "default_entity_id": ")" + "select." + unique_id + R"(",
        "unique_id": ")" + unique_id + R"(",
        "icon": "mdi:swap-horizontal",
        "cmd_t": ")" + topic_base + R"(/cmd_ac/swing_horizontal",
        "stat_t": ")" + topic_base + R"(/state",
        "val_tpl": "{{ value_json.swing_horizontal }}",
        "options": )" + build_options_json(app_lang_, "swingHorizontal") + R"(,
        "avty_t": ")" + topic_base + R"(/status",
        "pl_avail": "online",
        "pl_not_avail": "offline")" +
        build_common_config_suffix() + R"(
      })";

      if (recreate) {
        publish_async(config_topic, std::string(""), 1, true);
        set_timeout("mqtt_publish_discovery_swing_horizontal_select_publish", mqtt_delay_rebuild_, [this, config_topic, payload]() {
          publish_async(config_topic, payload, 1, true);
        });
      } else {
        publish_async(config_topic, payload, 1, true);
      }
    }

    void ACW02::publish_discovery_preset_select(bool recreate) {
      if (!mqtt_)
      return;

      const std::string topic_base = app_name_;
      const std::string unique_id = app_sanitize_name_ + "_mqtt_preset_list";

      std::string config_topic = "homeassistant/select/" + topic_base + "-preset-list/config";

      std::string payload = R"({
        "name": ")" + get_localized_name(app_lang_, "presetList") + R"(",
        "default_entity_id": ")" + "select." + unique_id + R"(",
        "unique_id": ")" + unique_id + R"(",
        "icon": "mdi:content-save",
        "cmd_t": ")" + topic_base + R"(/cmd_ac/presets_list_element",
        "stat_t": ")" + topic_base + R"(/state",
        "val_tpl": "{{ value_json.presets_list_element }}",
        "options": )" + get_preset_list(true) + R"(,
        "avty_t": ")" + topic_base + R"(/status",
        "pl_avail": "online",
        "pl_not_avail": "offline")" +
        build_common_config_suffix() + R"(
      })";

      if (recreate) {
        publish_async(config_topic, std::string(""), 1, true);
        set_timeout("publish_discovery_preset_select", mqtt_delay_rebuild_, [this, config_topic, payload]() {
          publish_async(config_topic, payload, 1, true);
        });
      } else {
        publish_async(config_topic, payload, 1, true);
      }
    }

    void ACW02::publish_discovery_preset_config_select(bool recreate) {
      if (!mqtt_)
      return;

      const std::string topic_base = app_name_;
      const std::string unique_id = app_sanitize_name_ + "_mqtt_preset_list_config";

      std::string config_topic = "homeassistant/select/" + topic_base + "-preset-list-config/config";

      std::string payload = R"({
        "name": ")" + get_localized_name(app_lang_, "presetListConfig") + R"(",
        "default_entity_id": ")" + "select." + unique_id + R"(",
        "unique_id": ")" + unique_id + R"(",
        "entity_category": "config",
        "icon": "mdi:content-save",
        "cmd_t": ")" + topic_base + R"(/cmd/presets_list_element_config",
        "stat_t": ")" + topic_base + R"(/state",
        "val_tpl": "{{ value_json.presets_list_element_config }}",
        "options": )" + get_preset_list(false) + R"(,
        "avty_t": ")" + topic_base + R"(/status",
        "pl_avail": "online",
        "pl_not_avail": "offline")" +
        build_common_config_suffix() + R"(
      })";

      if (recreate) {
        publish_async(config_topic, std::string(""), 1, true);
        set_timeout("publish_discovery_preset_config_select", mqtt_delay_rebuild_, [this, config_topic, payload]() {
          publish_async(config_topic, payload, 1, true);
        });
      } else {
        publish_async(config_topic, payload, 1, true);
      }
    }

    void ACW02::publish_discovery_clean_switch(bool recreate) {
      if (!mqtt_) return;

      const std::string topic_base = app_name_;
      const std::string unique_id = app_sanitize_name_ + "_mqtt_clean";

      std::string config_topic = "homeassistant/switch/" + topic_base + "-clean/config";

      std::string payload = R"({
        "name": ")" + get_localized_name(app_lang_, "clean") + R"(",
        "default_entity_id": ")" + "switch." + unique_id + R"(",
        "unique_id": ")" + unique_id + R"(",
        "icon": "mdi:spray-bottle",
        "cmd_t": ")" + topic_base + R"(/cmd_ac/clean",
        "stat_t": ")" + topic_base + R"(/state",
        "val_tpl": "{{ value_json.clean }}",
        "pl_on": "on",
        "pl_off": "off",
        "availability_mode": "all",
        "availability": [
        {
          "topic": ")" + topic_base + R"(/status",
          "payload_available": "online",
          "payload_not_available": "offline"
        },
        {
          "topic": ")" + topic_base + R"(/clean_availability",
          "payload_available": "available",
          "payload_not_available": "unavailable"
        }
        ])" +
        build_common_config_suffix() + R"(
      })";


      if (recreate) {
        publish_async(config_topic, std::string(""), 1, true);
        set_timeout("mqtt_publish_discovery_clean_switch_publish", mqtt_delay_rebuild_, [this, config_topic, payload]() {
          publish_async(config_topic, payload, 1, true);
        });
      } else {
        publish_async(config_topic, payload, 1, true);
      }
    }

    void ACW02::publish_discovery_eco_switch(bool recreate) {
      if (!mqtt_) return;

      const std::string topic_base = app_name_;
      const std::string unique_id = app_sanitize_name_ + "_mqtt_eco";

      std::string config_topic = "homeassistant/switch/" + topic_base + "-eco/config";

      std::string payload = R"({
        "name": ")" + get_localized_name(app_lang_, "eco") + R"(",
        "default_entity_id": ")" + "switch." + unique_id + R"(",
        "unique_id": ")" + unique_id + R"(",
        "icon": "mdi:currency-usd-off",
        "cmd_t": ")" + topic_base + R"(/cmd_ac/eco",
        "stat_t": ")" + topic_base + R"(/state",
        "availability_mode": "all",
        "availability_template": "{{ value_json.mode == 'cool' }}",
        "val_tpl": "{{ value_json.eco }}",
        "pl_on": "on",
        "pl_off": "off",
        "availability_mode": "all",
        "availability": [
        {
          "topic": ")" + topic_base + R"(/status",
          "payload_available": "online",
          "payload_not_available": "offline"
        },
        {
          "topic": ")" + topic_base + R"(/eco_availability",
          "payload_available": "available",
          "payload_not_available": "unavailable"
        }
        ])" +
        build_common_config_suffix() + R"(
      })";

      if (recreate) {
        publish_async(config_topic, std::string(""), 1, true);
        set_timeout("mqtt_publish_discovery_eco_switch_publish", mqtt_delay_rebuild_, [this, config_topic, payload]() {
          publish_async(config_topic, payload, 1, true);
        });
      } else {
        publish_async(config_topic, payload, 1, true);
      }
    }

    void ACW02::publish_discovery_display_switch(bool recreate) {
      if (!mqtt_)
      return;

      const std::string topic_base = app_name_;
      const std::string unique_id = app_sanitize_name_ + "_mqtt_display";

      std::string config_topic = "homeassistant/switch/" + topic_base + "-display/config";

      std::string payload = R"({
        "name": ")" + get_localized_name(app_lang_, "display") + R"(",
        "default_entity_id": ")" + "switch." + unique_id + R"(",
        "unique_id": ")" + unique_id + R"(",
        "icon": "mdi:lightbulb",
        "cmd_t": ")" + topic_base + R"(/cmd_ac/display",
        "stat_t": ")" + topic_base + R"(/state",
        "val_tpl": "{{ value_json.display }}",
        "pl_on": "on",
        "pl_off": "off",
        "avty_t": ")" + topic_base + R"(/status",
        "pl_avail": "online",
        "pl_not_avail": "offline")" +
        build_common_config_suffix() + R"(
      })";

      if (recreate) {
        publish_async(config_topic, std::string(""), 1, true);
        set_timeout("mqtt_publish_discovery_display_switch_publish", mqtt_delay_rebuild_, [this, config_topic, payload]() {
          publish_async(config_topic, payload, 1, true);
        });
      } else {
        publish_async(config_topic, payload, 1, true);
      }
    }

    void ACW02::publish_discovery_night_switch(bool recreate) {
      if (!mqtt_)
      return;

      const std::string topic_base = app_name_;
      const std::string unique_id = app_sanitize_name_ + "_mqtt_night";

      std::string config_topic = "homeassistant/switch/" + topic_base + "-night/config";

      std::string payload = R"({
        "name": ")" + get_localized_name(app_lang_, "night") + R"(",
        "default_entity_id": ")" + "switch." + unique_id + R"(",
        "unique_id": ")" + unique_id + R"(",
        "cmd_t": ")" + topic_base + R"(/cmd_ac/night",
        "stat_t": ")" + topic_base + R"(/state",
        "val_tpl": "{{ value_json.night }}",
        "pl_on": "on",
        "pl_off": "off",
        "icon": "mdi:power-sleep",
        "availability_mode": "all",
        "availability": [
        {
          "topic": ")" + topic_base + R"(/status",
          "payload_available": "online",
          "payload_not_available": "offline"
        },
        {
          "topic": ")" + topic_base + R"(/night_availability",
          "payload_available": "available",
          "payload_not_available": "unavailable"
        }
        ])" +
        build_common_config_suffix() + R"(
      })";

      if (recreate) {
        publish_async(config_topic, std::string(""), 1, true);
        set_timeout("mqtt_publish_discovery_night_switch_publish", mqtt_delay_rebuild_, [this, config_topic, payload]() {
          publish_async(config_topic, payload, 1, true);
        });
      } else {
        publish_async(config_topic, payload, 1, true);
      }
    }

    void ACW02::publish_discovery_purifier_switch(bool recreate) {
      if (!mqtt_)
      return;

      const std::string topic_base = app_name_;
      const std::string unique_id = app_sanitize_name_ + "_mqtt_purifier";

      std::string config_topic = "homeassistant/switch/" + topic_base + "-purifier/config";

      std::string payload = R"({
        "name": ")" + get_localized_name(app_lang_, "purifier") + R"(",
        "default_entity_id": ")" + "switch." + unique_id + R"(",
        "unique_id": ")" + unique_id + R"(",
        "cmd_t": ")" + topic_base + R"(/cmd_ac/purifier",
        "stat_t": ")" + topic_base + R"(/state",
        "val_tpl": "{{ value_json.purifier }}",
        "pl_on": "on",
        "pl_off": "off",
        "icon": "mdi:leaf-circle",
        "availability_mode": "all",
        "availability": [
        {
          "topic": ")" + topic_base + R"(/status",
          "payload_available": "online",
          "payload_not_available": "offline"
        },
        {
          "topic": ")" + topic_base + R"(/purifier_availability",
          "payload_available": "available",
          "payload_not_available": "unavailable"
        }
        ])" +
        build_common_config_suffix() + R"(
      })";

      if (recreate) {
        publish_async(config_topic, std::string(""), 1, true);
        set_timeout("mqtt_publish_discovery_purifier_switch_publish", mqtt_delay_rebuild_, [this, config_topic, payload]() {
          publish_async(config_topic, payload, 1, true);
        });
      } else {
        publish_async(config_topic, payload, 1, true);
      }
    }

    void ACW02::publish_discovery_g1_mute_switch(bool recreate) {
      if (!mqtt_)
      return;

      const std::string topic_base = app_name_;
      const std::string unique_id = app_sanitize_name_ + "_mqtt_g1_mute";

      std::string config_topic = "homeassistant/switch/" + topic_base + "-g1-mute/config";

      if (!option_g1_mqtt_) {
        publish_async(config_topic, std::string(""), 1, true);
        return;
      }

      std::string payload = R"({
        "name": ")" + get_localized_name(app_lang_, "g1Mute") + R"(",
        "default_entity_id": ")" + "switch." + unique_id + R"(",
        "unique_id": ")" + unique_id + R"(",
        "cmd_t": ")" + topic_base + R"(/cmd/g1_mute",
        "stat_t": ")" + topic_base + R"(/state",
        "val_tpl": "{{ value_json.g1_mute }}",
        "pl_on": "on",
        "pl_off": "off",
        "icon": "mdi:volume-off",
        "entity_category": "config",
        "avty_t": ")" + topic_base + R"(/status",
        "pl_avail": "online",
        "pl_not_avail": "offline")" +
        build_common_config_suffix() + R"(
      })";

      if (recreate) {
        publish_async(config_topic, std::string(""), 1, true);
        set_timeout("mqtt_publish_discovery_g1_mute_switch_publish", mqtt_delay_rebuild_, [this, config_topic, payload]() {
          publish_async(config_topic, payload, 1, true);
        });
      } else {
        publish_async(config_topic, payload, 1, true);
      }
    }

    void ACW02::publish_discovery_g1_reset_eco_purifier_ac_off_switch(bool recreate) {
      if (!mqtt_)
      return;

      const std::string topic_base = app_name_;
      const std::string unique_id = app_sanitize_name_ + "_mqtt_reset_eco_purifier";

      std::string config_topic = "homeassistant/switch/" + topic_base + "-g1-reset-eco-purifier/config";

      if (!option_g1_mqtt_) {
        publish_async(config_topic, std::string(""), 1, true);
        return;
      }

      std::string payload = R"({
        "name": ")" + get_localized_name(app_lang_, "resetEcoPurifier") + R"(",
        "default_entity_id": ")" + "switch." + unique_id + R"(",
        "unique_id": ")" + unique_id + R"(",
        "cmd_t": ")" + topic_base + R"(/cmd/g1_reset_eco_purifier",
        "stat_t": ")" + topic_base + R"(/state",
        "val_tpl": "{{ value_json.g1_reset_eco_purifier }}",
        "pl_on": "on",
        "pl_off": "off",
        "icon": "mdi:lock-reset",
        "entity_category": "config",
        "avty_t": ")" + topic_base + R"(/status",
        "pl_avail": "online",
        "pl_not_avail": "offline")" +
        build_common_config_suffix() + R"(
      })";

      if (recreate) {
        publish_async(config_topic, std::string(""), 1, true);
        set_timeout("mqtt_publish_discovery_g1_reset_eco_purifier_ac_off_switch_publish", mqtt_delay_rebuild_, [this, config_topic, payload]() {
          publish_async(config_topic, payload, 1, true);
        });
      } else {
        publish_async(config_topic, payload, 1, true);
      }
    }

    void ACW02::publish_discovery_g1_option_recalculate_climate_switch(bool recreate) {
      if (!mqtt_)
      return;

      const std::string topic_base = app_name_;
      const std::string unique_id = app_sanitize_name_ + "_mqtt_g1_option_recalculate_climate";

      std::string config_topic = "homeassistant/switch/" + topic_base + "-g1-option-recalculate-climate/config";

      if (!option_g1_mqtt_) {
        publish_async(config_topic, std::string(""), 1, true);
        return;
      }

      std::string payload = R"({
        "name": ")" + get_localized_name(app_lang_, "g1OptionRecalculateClimate") + R"(",
        "default_entity_id": ")" + "switch." + unique_id + R"(",
        "unique_id": ")" + unique_id + R"(",
        "cmd_t": ")" + topic_base + R"(/cmd/g1_option_recalculate_climate",
        "stat_t": ")" + topic_base + R"(/state",
        "val_tpl": "{{ value_json.g1_option_recalculate_climate }}",
        "pl_on": "on",
        "pl_off": "off",
        "entity_category": "config",
        "icon": "mdi:autorenew",
        "avty_t": ")" + topic_base + R"(/status",
        "pl_avail": "online",
        "pl_not_avail": "offline")" +
        build_common_config_suffix() + R"(
      })";

      if (recreate) {
        publish_async(config_topic, std::string(""), 1, true);
        set_timeout("mqtt_publish_discovery_g1_option_recalculate_climate_switch_publish", mqtt_delay_rebuild_, [this, config_topic, payload]() {
          publish_async(config_topic, payload, 1, true);
        });
      } else {
        publish_async(config_topic, payload, 1, true);
      }
    }

    void ACW02::publish_discovery_disable_mode_auto_switch(bool recreate) {
      if (!mqtt_)
      return;

      const std::string topic_base = app_name_;
      const std::string unique_id = app_sanitize_name_ + "_mqtt_disable_mode_auto";

      std::string config_topic = "homeassistant/switch/" + topic_base + "-disable-mode-auto/config";

      if (!option_g1_mqtt_) {
        publish_async(config_topic, std::string(""), 1, true);
        return;
      }

      std::string payload = R"({
        "name": ")" + get_localized_name(app_lang_, "disableModeAuto") + R"(",
        "default_entity_id": ")" + "switch." + unique_id + R"(",
        "unique_id": ")" + unique_id + R"(",
        "cmd_t": ")" + topic_base + R"(/cmd/disable_mode_auto",
        "stat_t": ")" + topic_base + R"(/state",
        "val_tpl": "{{ value_json.disable_mode_auto }}",
        "pl_on": "on",
        "pl_off": "off",
        "entity_category": "config",
        "icon": "mdi:thermostat-cog",
        "avty_t": ")" + topic_base + R"(/status",
        "pl_avail": "online",
        "pl_not_avail": "offline")" +
        build_common_config_suffix() + R"(
      })";

      if (recreate) {
        publish_async(config_topic, std::string(""), 1, true);
        set_timeout("mqtt_publish_discovery_disable_mode_auto_switch_publish", mqtt_delay_rebuild_, [this, config_topic, payload]() {
          publish_async(config_topic, payload, 1, true);
        });
      } else {
        publish_async(config_topic, payload, 1, true);
      }
    }

    void ACW02::publish_discovery_disable_mode_heat_switch(bool recreate) {
      if (!mqtt_)
      return;

      const std::string topic_base = app_name_;
      const std::string unique_id = app_sanitize_name_ + "_mqtt_disable_mode_heat";

      std::string config_topic = "homeassistant/switch/" + topic_base + "-disable-mode-heat/config";

      if (!option_g1_mqtt_) {
        publish_async(config_topic, std::string(""), 1, true);
        return;
      }

      std::string payload = R"({
        "name": ")" + get_localized_name(app_lang_, "disableModeHeat") + R"(",
        "default_entity_id": ")" + "switch." + unique_id + R"(",
        "unique_id": ")" + unique_id + R"(",
        "cmd_t": ")" + topic_base + R"(/cmd/disable_mode_heat",
        "stat_t": ")" + topic_base + R"(/state",
        "val_tpl": "{{ value_json.disable_mode_heat }}",
        "pl_on": "on",
        "pl_off": "off",
        "entity_category": "config",
        "icon": "mdi:thermostat-cog",
        "avty_t": ")" + topic_base + R"(/status",
        "pl_avail": "online",
        "pl_not_avail": "offline")" +
        build_common_config_suffix() + R"(
      })";

      if (recreate) {
        publish_async(config_topic, std::string(""), 1, true);
        set_timeout("mqtt_publish_discovery_disable_mode_heat_switch_publish", mqtt_delay_rebuild_, [this, config_topic, payload]() {
          publish_async(config_topic, payload, 1, true);
        });
      } else {
        publish_async(config_topic, payload, 1, true);
      }
    }

    void ACW02::publish_discovery_disable_mode_dry_switch(bool recreate) {
      if (!mqtt_)
      return;

      const std::string topic_base = app_name_;
      const std::string unique_id = app_sanitize_name_ + "_mqtt_disable_mode_dry";

      std::string config_topic = "homeassistant/switch/" + topic_base + "-disable-mode-dry/config";

      if (!option_g1_mqtt_) {
        publish_async(config_topic, std::string(""), 1, true);
        return;
      }

      std::string payload = R"({
        "name": ")" + get_localized_name(app_lang_, "disableModeDry") + R"(",
        "default_entity_id": ")" + "switch." + unique_id + R"(",
        "unique_id": ")" + unique_id + R"(",
        "cmd_t": ")" + topic_base + R"(/cmd/disable_mode_dry",
        "stat_t": ")" + topic_base + R"(/state",
        "val_tpl": "{{ value_json.disable_mode_dry }}",
        "pl_on": "on",
        "pl_off": "off",
        "entity_category": "config",
        "icon": "mdi:thermostat-cog",
        "avty_t": ")" + topic_base + R"(/status",
        "pl_avail": "online",
        "pl_not_avail": "offline")" +
        build_common_config_suffix() + R"(
      })";

      if (recreate) {
        publish_async(config_topic, std::string(""), 1, true);
        set_timeout("mqtt_publish_discovery_disable_mode_dry_switch_publish", mqtt_delay_rebuild_, [this, config_topic, payload]() {
          publish_async(config_topic, payload, 1, true);
        });
      } else {
        publish_async(config_topic, payload, 1, true);
      }
    }

    void ACW02::publish_discovery_disable_mode_fan_switch(bool recreate) {
      if (!mqtt_)
      return;

      const std::string topic_base = app_name_;
      const std::string unique_id = app_sanitize_name_ + "_mqtt_disable_mode_fan";

      std::string config_topic = "homeassistant/switch/" + topic_base + "-disable-mode-fan/config";

      if (!option_g1_mqtt_) {
        publish_async(config_topic, std::string(""), 1, true);
        return;
      }

      std::string payload = R"({
        "name": ")" + get_localized_name(app_lang_, "disableModeFan") + R"(",
        "default_entity_id": ")" + "switch." + unique_id + R"(",
        "unique_id": ")" + unique_id + R"(",
        "cmd_t": ")" + topic_base + R"(/cmd/disable_mode_fan",
        "stat_t": ")" + topic_base + R"(/state",
        "val_tpl": "{{ value_json.disable_mode_fan }}",
        "pl_on": "on",
        "pl_off": "off",
        "entity_category": "config",
        "icon": "mdi:thermostat-cog",
        "avty_t": ")" + topic_base + R"(/status",
        "pl_avail": "online",
        "pl_not_avail": "offline")" +
        build_common_config_suffix() + R"(
      })";

      if (recreate) {
        publish_async(config_topic, std::string(""), 1, true);
        set_timeout("mqtt_publish_discovery_disable_mode_fan_switch_publish", mqtt_delay_rebuild_, [this, config_topic, payload]() {
          publish_async(config_topic, payload, 1, true);
        });
      } else {
        publish_async(config_topic, payload, 1, true);
      }
    }

    void ACW02::publish_discovery_disable_swing_vertical_switch(bool recreate) {
      if (!mqtt_)
      return;

      const std::string topic_base = app_name_;
      const std::string unique_id = app_sanitize_name_ + "_mqtt_disable_swing_vertical";

      std::string config_topic = "homeassistant/switch/" + topic_base + "-disable-swing_vertical/config";

      if (!option_g1_mqtt_) {
        publish_async(config_topic, std::string(""), 1, true);
        return;
      }

      std::string payload = R"({
        "name": ")" + get_localized_name(app_lang_, "disableSwingVertical") + R"(",
        "default_entity_id": ")" + "switch." + unique_id + R"(",
        "unique_id": ")" + unique_id + R"(",
        "cmd_t": ")" + topic_base + R"(/cmd/disable_swing_vertical",
        "stat_t": ")" + topic_base + R"(/state",
        "val_tpl": "{{ value_json.disable_swing_vertical }}",
        "pl_on": "on",
        "pl_off": "off",
        "entity_category": "config",
        "icon": "mdi:thermostat-cog",
        "avty_t": ")" + topic_base + R"(/status",
        "pl_avail": "online",
        "pl_not_avail": "offline")" +
        build_common_config_suffix() + R"(
      })";

      if (recreate) {
        publish_async(config_topic, std::string(""), 1, true);
        set_timeout("mqtt_publish_discovery_disable_swing_vertical_switch_publish", mqtt_delay_rebuild_, [this, config_topic, payload]() {
          publish_async(config_topic, payload, 1, true);
        });
      } else {
        publish_async(config_topic, payload, 1, true);
      }
    }

    void ACW02::publish_discovery_disable_swing_horizontal_switch(bool recreate) {
      if (!mqtt_)
      return;

      const std::string topic_base = app_name_;
      const std::string unique_id = app_sanitize_name_ + "_mqtt_disable_swing_horizontal";

      std::string config_topic = "homeassistant/switch/" + topic_base + "-disable-swing_horizontal/config";

      if (!option_g1_mqtt_) {
        publish_async(config_topic, std::string(""), 1, true);
        return;
      }

      std::string payload = R"({
        "name": ")" + get_localized_name(app_lang_, "disableSwingHorizontal") + R"(",
        "default_entity_id": ")" + "switch." + unique_id + R"(",
        "unique_id": ")" + unique_id + R"(",
        "cmd_t": ")" + topic_base + R"(/cmd/disable_swing_horizontal",
        "stat_t": ")" + topic_base + R"(/state",
        "val_tpl": "{{ value_json.disable_swing_horizontal }}",
        "pl_on": "on",
        "pl_off": "off",
        "entity_category": "config",
        "icon": "mdi:thermostat-cog",
        "avty_t": ")" + topic_base + R"(/status",
        "pl_avail": "online",
        "pl_not_avail": "offline")" +
        build_common_config_suffix() + R"(
      })";

      if (recreate) {
        publish_async(config_topic, std::string(""), 1, true);
        set_timeout("mqtt_publish_discovery_disable_swing_horizontal_switch_publish", mqtt_delay_rebuild_, [this, config_topic, payload]() {
          publish_async(config_topic, payload, 1, true);
        });
      } else {
        publish_async(config_topic, payload, 1, true);
      }
    }

    void ACW02::publish_discovery_preset_switch(bool recreate) {
      if (!mqtt_)
      return;

      const std::string topic_base = app_name_;
      const std::string unique_id = app_sanitize_name_ + "_mqtt_preset";

      std::string config_topic = "homeassistant/switch/" + topic_base + "-preset/config";

      std::string payload = R"({
        "name": ")" + get_localized_name(app_lang_, "preset") + R"(",
        "default_entity_id": ")" + "switch." + unique_id + R"(",
        "unique_id": ")" + unique_id + R"(",
        "cmd_t": ")" + topic_base + R"(/cmd/preset",
        "stat_t": ")" + topic_base + R"(/state",
        "val_tpl": "{{ value_json.preset }}",
        "pl_on": "on",
        "pl_off": "off",
        "entity_category": "config",
        "icon": "mdi:thermostat-cog",
        "avty_t": ")" + topic_base + R"(/status",
        "pl_avail": "online",
        "pl_not_avail": "offline")" +
        build_common_config_suffix() + R"(
      })";

      if (recreate) {
        publish_async(config_topic, std::string(""), 1, true);
        set_timeout("mqtt_publish_discovery_preset_switch_publish", mqtt_delay_rebuild_, [this, config_topic, payload]() {
          publish_async(config_topic, payload, 1, true);
        });
      } else {
        publish_async(config_topic, payload, 1, true);
      }
    }

    void ACW02::publish_discovery_g1_mute_next_cmd_delay_text(bool recreate) {
      if (!mqtt_)
        return;

      const std::string topic_base = app_name_;
      const std::string unique_id = app_sanitize_name_ + "_mqtt_g1_mute_next_cmd_delay";

      std::string config_topic = "homeassistant/text/" + topic_base + "-g1-mute-next-cmd-delay/config";

      if (!option_g1_mqtt_) {
        publish_async(config_topic, std::string(""), 1, true);
        return;
      }

      std::string payload = R"({
        "name": ")" + get_localized_name(app_lang_, "ZCMDMuteDelay") + R"(",
        "default_entity_id": ")" + "text." + unique_id + R"(",
        "unique_id": ")" + unique_id + R"(",
        "cmd_t": ")" + topic_base + R"(/cmd/g1_mute_next_cmd_delay",
        "stat_t": ")" + topic_base + R"(/state",
        "val_tpl": "{{ value_json.g1_mute_next_cmd_delay }}",
        "entity_category": "config",
        "mode": "text",
        "icon": "mdi:volume-off",
        "avty_t": ")" + topic_base + R"(/status",
        "pl_avail": "online",
        "pl_not_avail": "offline")" +
        build_common_config_suffix() + R"(
      })";

      if (recreate) {
        publish_async(config_topic, std::string(""), 1, true);
        set_timeout("mqtt_publish_discovery_g1_mute_next_cmd_delay_text_publish", mqtt_delay_rebuild_, [this, config_topic, payload]() {
          publish_async(config_topic, payload, 1, true);
        });
      } else {
        publish_async(config_topic, payload, 1, true);
      }
    }

    void ACW02::publish_discovery_g1_mute_next_cmd_after_on_delay_text(bool recreate) {
      if (!mqtt_)
        return;

      const std::string topic_base = app_name_;
      const std::string unique_id = app_sanitize_name_ + "_mqtt_g1_mute_next_cmd_after_on_delay";

      std::string config_topic = "homeassistant/text/" + topic_base + "-g1-mute-next-cmd-after-on-delay/config";

      if (!option_g1_mqtt_) {
        publish_async(config_topic, std::string(""), 1, true);
        return;
      }

      std::string payload = R"({
        "name": ")" + get_localized_name(app_lang_, "ZCMDMuteAfterOnDelay") + R"(",
        "default_entity_id": ")" + "text." + unique_id + R"(",
        "unique_id": ")" + unique_id + R"(",
        "cmd_t": ")" + topic_base + R"(/cmd/g1_mute_next_cmd_after_on_delay",
        "stat_t": ")" + topic_base + R"(/state",
        "val_tpl": "{{ value_json.g1_mute_next_cmd_after_on_delay }}",
        "entity_category": "config",
        "mode": "text",
        "icon": "mdi:volume-off",
        "avty_t": ")" + topic_base + R"(/status",
        "pl_avail": "online",
        "pl_not_avail": "offline")" +
        build_common_config_suffix() + R"(
      })";

      if (recreate) {
        publish_async(config_topic, std::string(""), 1, true);
        set_timeout("mqtt_publish_discovery_g1_mute_next_cmd_after_on_delay_text_publish", mqtt_delay_rebuild_, [this, config_topic, payload]() {
          publish_async(config_topic, payload, 1, true);
        });
      } else {
        publish_async(config_topic, payload, 1, true);
      }
    }

    void ACW02::publish_discovery_g1_publish_stats_after_power_on_delay_text(bool recreate) {
      if (!mqtt_)
        return;

      const std::string topic_base = app_name_;
      const std::string unique_id = app_sanitize_name_ + "_mqtt_g1_publish_stats_after_power_on_delay";

      std::string config_topic = "homeassistant/text/" + topic_base + "-g1-publish-stats-after-power-on-delay/config";

      if (!option_g1_mqtt_) {
        publish_async(config_topic, std::string(""), 1, true);
        return;
      }

      std::string payload = R"({
        "name": ")" + get_localized_name(app_lang_, "ZCMDPublishAfterOnDelay") + R"(",
        "default_entity_id": ")" + "text." + unique_id + R"(",
        "unique_id": ")" + unique_id + R"(",
        "cmd_t": ")" + topic_base + R"(/cmd/g1_publish_stats_after_power_on_delay",
        "stat_t": ")" + topic_base + R"(/state",
        "val_tpl": "{{ value_json.g1_publish_stats_after_power_on_delay }}",
        "entity_category": "config",
        "mode": "text",
        "icon": "mdi:publish",
        "avty_t": ")" + topic_base + R"(/status",
        "pl_avail": "online",
        "pl_not_avail": "offline")" +
        build_common_config_suffix() + R"(
      })";

      if (recreate) {
        publish_async(config_topic, std::string(""), 1, true);
        set_timeout("mqtt_publish_discovery_g1_publish_stats_after_power_on_delay_text_publish", mqtt_delay_rebuild_, [this, config_topic, payload]() {
          publish_async(config_topic, payload, 1, true);
        });
      } else {
        publish_async(config_topic, payload, 1, true);
      }
    }

    void ACW02::publish_discovery_preset_name_config_text(bool recreate) {
      if (!mqtt_)
        return;

      const std::string topic_base = app_name_;
      const std::string unique_id = app_sanitize_name_ + "_mqtt_preset_name_config";

      std::string config_topic = "homeassistant/text/" + topic_base + "-preset-name-config/config";

      std::string payload = R"({
        "name": ")" + get_localized_name(app_lang_, "presetName") + R"(",
        "default_entity_id": ")" + "text." + unique_id + R"(",
        "unique_id": ")" + unique_id + R"(",
        "cmd_t": ")" + topic_base + R"(/cmd/preset_name_config",
        "stat_t": ")" + topic_base + R"(/state",
        "val_tpl": "{{ value_json.preset_name_config }}",
        "entity_category": "config",
        "mode": "text",
        "icon": "mdi:content-save",
        "avty_t": ")" + topic_base + R"(/status",
        "pl_avail": "online",
        "pl_not_avail": "offline")" +
        build_common_config_suffix() + R"(
      })";

      if (recreate) {
        publish_async(config_topic, std::string(""), 1, true);
        set_timeout("publish_discovery_preset_name_config_text", mqtt_delay_rebuild_, [this, config_topic, payload]() {
          publish_async(config_topic, payload, 1, true);
        });
      } else {
        publish_async(config_topic, payload, 1, true);
      }
    }

    void ACW02::publish_discovery_temperature_number(bool recreate) {
      if (!mqtt_)
      return;

      const std::string topic_base = app_name_;
      const std::string unit = use_fahrenheit_ ? "°F" : "°C";
      const std::string temp_suffix = use_fahrenheit_ ? "_f" : "_c";
      const std::string unique_id = app_sanitize_name_ + "_mqtt_temp";
      const std::string icon = use_fahrenheit_ ? "mdi:temperature-fahrenheit" : "mdi:temperature-celsius";

      float min = use_fahrenheit_ ? 61.0f : 16.0f;
      float max = use_fahrenheit_ ? 88.0f : 31.0f;

      std::string config_topic = "homeassistant/number/" + topic_base + "-temp/config";

      std::string payload = R"({
        "name": ")" + get_localized_name(app_lang_, "temp") + R"(",
        "default_entity_id": ")" + "number." + unique_id + R"(",
        "unique_id": ")" + unique_id + R"(",
        "cmd_t": ")" + topic_base + "/cmd_ac/temp" + temp_suffix + R"(",
        "stat_t": ")" + topic_base + R"(/state",
        "val_tpl": "{{ value_json.temp)" + temp_suffix + R"( }}",
        "min": )" + to_string(min) + R"(,
        "max": )" + to_string(max) + R"(,
        "step": 1,
        "mode": "box",
        "icon": ")" + icon + R"(",
        "unit_of_meas": ")" + unit + R"(",
        "availability_mode": "all",
        "availability": [
        {
          "topic": ")" + topic_base + R"(/status",
          "payload_available": "online",
          "payload_not_available": "offline"
        },
        {
          "topic": ")" + topic_base + R"(/target_temp_availability",
          "payload_available": "available",
          "payload_not_available": "unavailable"
        }
        ])" +
        build_common_config_suffix() + R"(
      })";

      if (recreate) {
        publish_async(config_topic, std::string(""), 1, true);
        set_timeout("mqtt_publish_discovery_temperature_number_publish", mqtt_delay_rebuild_, [this, config_topic, payload]() {
          publish_async(config_topic, payload, 1, true);
        });
      } else {
        publish_async(config_topic, payload, 1, true);
      }
    }

    void ACW02::publish_discovery_g1_reload_button(bool recreate) {
      if (!mqtt_)
        return;

      const std::string topic_base = app_name_;
      const std::string unique_id = app_sanitize_name_ + "_mqtt_g1_restart_module_ac";
      const std::string config_topic = "homeassistant/button/" + topic_base + "-g1-restart-module-ac/config";

      if (!option_g1_mqtt_) {
        publish_async(config_topic, std::string(""), 1, true);
        return;
      }

      std::string payload = R"({
        "name": ")" + get_localized_name(app_lang_, "restartModule") + R"(",
        "default_entity_id": ")" + "button." + unique_id + R"(",
        "unique_id": ")" + unique_id + R"(",
        "cmd_t": ")" + topic_base + R"(/cmd/g1_restart_module_ac",
        "icon": "mdi:restart",
        "entity_category": "config",
        "avty_t": ")" + topic_base + R"(/status",
        "pl_avail": "online",
        "pl_not_avail": "offline")" +
        build_common_config_suffix() + R"(
      })";

      if (recreate) {
        publish_async(config_topic, std::string(""), 1, true);
        set_timeout("mqtt_publish_discovery_g1_reload_button_publish", mqtt_delay_rebuild_, [this, config_topic, payload]() {
          publish_async(config_topic, payload, 1, true);
        });
      } else {
        publish_async(config_topic, payload, 1, true);
      }
    }

    void ACW02::publish_discovery_g1_rebuild_mqtt_entities_button(bool recreate) {
      if (!mqtt_)
        return;

      const std::string topic_base = app_name_;
      const std::string unique_id = app_sanitize_name_ + "_mqtt_g1_rebuild_mqtt_entities";
      const std::string config_topic = "homeassistant/button/" + topic_base + "-g1-rebuild-mqtt-entities/config";

      if (!option_g1_mqtt_) {
        publish_async(config_topic, std::string(""), 1, true);
        return;
      }

      std::string payload = R"({
        "name": ")" + get_localized_name(app_lang_, "rebuildMQTT") + R"(",
        "default_entity_id": ")" + "button." + unique_id + R"(",
        "unique_id": ")" + unique_id + R"(",
        "cmd_t": ")" + topic_base + R"(/cmd/g1_rebuild_mqtt_entities",
        "icon": "mdi:cloud-refresh-variant",
        "entity_category": "config",
        "avty_t": ")" + topic_base + R"(/status",
        "pl_avail": "online",
        "pl_not_avail": "offline")" +
        build_common_config_suffix() + R"(
      })";

      if (recreate) {
        publish_async(config_topic, std::string(""), 1, true);
        set_timeout("publish_discovery_g1_rebuild_mqtt_entities_button", mqtt_delay_rebuild_, [this, config_topic, payload]() {
          publish_async(config_topic, payload, 1, true);
        });
      } else {
        publish_async(config_topic, payload, 1, true);
      }
    }

    void ACW02::publish_discovery_g1_get_status_button(bool recreate) {
      if (!mqtt_)
        return;

      const std::string topic_base = app_name_;
      const std::string unique_id = app_sanitize_name_ + "_mqtt_g1_get_status";
      const std::string config_topic = "homeassistant/button/" + topic_base + "-g1-get-status/config";

      if (!option_g1_mqtt_) {
        publish_async(config_topic, std::string(""), 1, true);
        return;
      }

      std::string payload = R"({
        "name": ")" + get_localized_name(app_lang_, "getStatus") + R"(",
        "default_entity_id": ")" + "button." + unique_id + R"(",
        "unique_id": ")" + unique_id + R"(",
        "cmd_t": ")" + topic_base + R"(/cmd/g1_get_status",
        "icon": "mdi:cloud-refresh-variant",
        "entity_category": "config",
        "avty_t": ")" + topic_base + R"(/status",
        "pl_avail": "online",
        "pl_not_avail": "offline")" +
        build_common_config_suffix() + R"(
      })";

      if (recreate) {
        publish_async(config_topic, std::string(""), 1, true);
        set_timeout("publish_discovery_g1_get_status_button", mqtt_delay_rebuild_, [this, config_topic, payload]() {
          publish_async(config_topic, payload, 1, true);
        });
      } else {
        publish_async(config_topic, payload, 1, true);
      }
    }

    void ACW02::publish_discovery_z_config_validate_button(bool recreate) {
      if (!mqtt_)
        return;

      const std::string topic_base = app_name_;
      const std::string unique_id = app_sanitize_name_ + "_mqtt_z_config_validate";
      const std::string config_topic = "homeassistant/button/" + topic_base + "-z-config-validate/config";

      if (!option_g1_mqtt_) {
        publish_async(config_topic, std::string(""), 1, true);
        return;
      }

      std::string payload = R"({
        "name": ")" + get_localized_name(app_lang_, "disableValidate") + R"(",
        "default_entity_id": ")" + "button." + unique_id + R"(",
        "unique_id": ")" + unique_id + R"(",
        "cmd_t": ")" + topic_base + R"(/cmd/z_config_validate",
        "icon": "mdi:send",
        "entity_category": "config",
        "avty_t": ")" + topic_base + R"(/status",
        "pl_avail": "online",
        "pl_not_avail": "offline")" +
        build_common_config_suffix() + R"(
      })";

      if (recreate) {
        publish_async(config_topic, std::string(""), 1, true);
        set_timeout("publish_discovery_z_config_validate_button", mqtt_delay_rebuild_, [this, config_topic, payload]() {
          publish_async(config_topic, payload, 1, true);
        });
      } else {
        publish_async(config_topic, payload, 1, true);
      }
    }

    void ACW02::publish_discovery_preset_save_button(bool recreate) {
      if (!mqtt_)
        return;

      const std::string topic_base = app_name_;
      const std::string unique_id = app_sanitize_name_ + "_mqtt_preset_save";
      const std::string config_topic = "homeassistant/button/" + topic_base + "-preset-save/config";

      std::string payload = R"({
        "name": ")" + get_localized_name(app_lang_, "presetSave") + R"(",
        "default_entity_id": ")" + "button." + unique_id + R"(",
        "unique_id": ")" + unique_id + R"(",
        "cmd_t": ")" + topic_base + R"(/cmd/preset_save",
        "icon": "mdi:content-save",
        "entity_category": "config",
        "avty_t": ")" + topic_base + R"(/status",
        "pl_avail": "online",
        "pl_not_avail": "offline")" +
        build_common_config_suffix() + R"(
      })";

      if (recreate) {
        publish_async(config_topic, std::string(""), 1, true);
        set_timeout("publish_discovery_preset_save_button", mqtt_delay_rebuild_, [this, config_topic, payload]() {
          publish_async(config_topic, payload, 1, true);
        });
      } else {
        publish_async(config_topic, payload, 1, true);
      }
    }

    void ACW02::publish_discovery_preset_delete_button(bool recreate) {
      if (!mqtt_)
        return;

      const std::string topic_base = app_name_;
      const std::string unique_id = app_sanitize_name_ + "_mqtt_preset_delete";
      const std::string config_topic = "homeassistant/button/" + topic_base + "-preset-delete/config";

      std::string payload = R"({
        "name": ")" + get_localized_name(app_lang_, "presetDelete") + R"(",
        "default_entity_id": ")" + "button." + unique_id + R"(",
        "unique_id": ")" + unique_id + R"(",
        "cmd_t": ")" + topic_base + R"(/cmd/preset_delete",
        "icon": "mdi:content-save",
        "entity_category": "config",
        "avty_t": ")" + topic_base + R"(/status",
        "pl_avail": "online",
        "pl_not_avail": "offline")" +
        build_common_config_suffix() + R"(
      })";

      if (recreate) {
        publish_async(config_topic, std::string(""), 1, true);
        set_timeout("publish_discovery_preset_delete_button", mqtt_delay_rebuild_, [this, config_topic, payload]() {
          publish_async(config_topic, payload, 1, true);
        });
      } else {
        publish_async(config_topic, payload, 1, true);
      }
    }

    void ACW02::publish_discovery_temperature_sensor(bool recreate) {
      if (!mqtt_) return;

      const std::string topic_base = app_name_;
      const std::string unit = use_fahrenheit_ ? "°F" : "°C";
      const std::string temp_suffix = use_fahrenheit_ ? "_f" : "_c";
      const std::string unique_id = app_sanitize_name_ + "_mqtt_sensor_temp";
      const std::string icon = use_fahrenheit_ ? "mdi:temperature-fahrenheit" : "mdi:temperature-celsius";

      std::string config_topic = "homeassistant/sensor/" + topic_base + "-temp/config";

      std::string payload = R"({
        "name": ")" + get_localized_name(app_lang_, "ambient") + R"(",
        "default_entity_id": ")" + "sensor." + unique_id + R"(",
        "unique_id": ")" + unique_id + R"(",
        "stat_t": ")" + topic_base + R"(/state",
        "unit_of_meas": ")" + unit + R"(",
        "val_tpl": "{{ value_json.ambient)" + temp_suffix + R"( }}",
        "state_class": "measurement",
        "icon": ")" + icon + R"(",
        "avty_t": ")" + topic_base + R"(/status",
        "pl_avail": "online",
        "pl_not_avail": "offline")" +
        build_common_config_suffix() + R"(
      })";

      if (recreate) {
        publish_async(config_topic, std::string(""), 1, true);
        set_timeout("mqtt_publish_discovery_temp_sensor", mqtt_delay_rebuild_, [this, config_topic, payload]() {
          publish_async(config_topic, payload, 1, true);
        });
      } else {
        publish_async(config_topic, payload, 1, true);
      }
    }

    void ACW02::publish_discovery_last_cmd_origin_sensor(bool recreate) {
      if (!mqtt_) return;

      const std::string topic_base = app_name_;
      const std::string unique_id = app_sanitize_name_ + "_mqtt_sensor_last_cmd_origin";

      std::string config_topic = "homeassistant/sensor/" + topic_base + "-last-cmd-origin/config";

      std::string payload = R"({
        "name": ")" + get_localized_name(app_lang_, "lastCmdOrigin") + R"(",
        "default_entity_id": ")" + "sensor." + unique_id + R"(",
        "unique_id": ")" + unique_id + R"(",
        "stat_t": ")" + topic_base + R"(/state",
        "icon" : "mdi:origin",
        "val_tpl": "{{ value_json.last_cmd_origin }}",
        "avty_t": ")" + topic_base + R"(/status",
        "pl_avail": "online",
        "pl_not_avail": "offline")" +
        build_common_config_suffix() + R"(
      })";

      if (recreate) {
        publish_async(config_topic, std::string(""), 1, true);
        set_timeout("mqtt_publish_discovery_last_cmd_origin_sensor", mqtt_delay_rebuild_, [this, config_topic, payload]() {
          publish_async(config_topic, payload, 1, true);
        });
      } else {
        publish_async(config_topic, payload, 1, true);
      }
    }

    void ACW02::publish_discovery_filter_dirty_sensor(bool recreate) {
      if (!mqtt_)
        return;

      const std::string topic_base = app_name_;
      const std::string unique_id = app_sanitize_name_ + "_mqtt_sensor_filter_dirty";
      std::string config_topic = "homeassistant/binary_sensor/" + topic_base + "-filter-dirty/config";

      std::string payload = R"({
        "name": ")" + get_localized_name(app_lang_, "filterToClean") + R"(",
        "default_entity_id": ")" + "binary_sensor." + unique_id + R"(",
        "unique_id": ")" + unique_id + R"(",
        "stat_t": ")" + topic_base + R"(/state",
        "icon": "mdi:air-filter",
        "val_tpl": "{{ value_json.filter_dirty }}",
        "device_class": "problem",
        "avty_t": ")" + topic_base + R"(/status",
        "pl_on": "true",
        "pl_off": "false",
        "pl_avail": "online",
        "pl_not_avail": "offline")" +
        build_common_config_suffix() + R"(
      })";

      if (recreate) {
        publish_async(config_topic, std::string(""), 1, true);
        set_timeout("mqtt_publish_discovery_filter_dirty_sensor", mqtt_delay_rebuild_, [this, config_topic, payload]() {
          publish_async(config_topic, payload, 1, true);
        });
      } else {
        publish_async(config_topic, payload, 1, true);
      }
    }

    void ACW02::publish_discovery_warn_sensor(bool recreate) {
      if (!mqtt_)
        return;

      const std::string topic_base = app_name_;
      const std::string unique_id = app_sanitize_name_ + "_mqtt_sensor_warn";
      std::string config_topic = "homeassistant/binary_sensor/" + topic_base + "-warn/config";

      std::string payload = R"({
        "name": ")" + get_localized_name(app_lang_, "warn") + R"(",
        "default_entity_id": ")" + "binary_sensor." + unique_id + R"(",
        "unique_id": ")" + unique_id + R"(",
        "stat_t": ")" + topic_base + R"(/state",
        "icon": "mdi:alert-circle-outline",
        "val_tpl": "{{ value_json.warn }}",
        "device_class": "problem",
        "avty_t": ")" + topic_base + R"(/status",
        "pl_on": "true",
        "pl_off": "false",
        "pl_avail": "online",
        "pl_not_avail": "offline")" +
        build_common_config_suffix() + R"(
      })";

      if (recreate) {
        publish_async(config_topic, std::string(""), 1, true);
        set_timeout("publish_discovery_warn_sensor", mqtt_delay_rebuild_, [this, config_topic, payload]() {
          publish_async(config_topic, payload, 1, true);
        });
      } else {
        publish_async(config_topic, payload, 1, true);
      }
    }

    void ACW02::publish_discovery_error_sensor(bool recreate) {
      if (!mqtt_)
        return;

      const std::string topic_base = app_name_;
      const std::string unique_id = app_sanitize_name_ + "_mqtt_sensor_error";
      std::string config_topic = "homeassistant/binary_sensor/" + topic_base + "-error/config";

      std::string payload = R"({
        "name": ")" + get_localized_name(app_lang_, "error") + R"(",
        "default_entity_id": ")" + "binary_sensor." + unique_id + R"(",
        "unique_id": ")" + unique_id + R"(",
        "stat_t": ")" + topic_base + R"(/state",
        "icon": "mdi:alert-octagon-outline",
        "val_tpl": "{{ value_json.error }}",
        "device_class": "problem",
        "avty_t": ")" + topic_base + R"(/status",
        "pl_on": "true",
        "pl_off": "false",
        "pl_avail": "online",
        "pl_not_avail": "offline")" +
        build_common_config_suffix() + R"(
      })";

      if (recreate) {
        publish_async(config_topic, std::string(""), 1, true);
        set_timeout("publish_discovery_error_sensor", mqtt_delay_rebuild_, [this, config_topic, payload]() {
          publish_async(config_topic, payload, 1, true);
        });
      } else {
        publish_async(config_topic, payload, 1, true);
      }
    }

    void ACW02::publish_discovery_cmd_failure_counter_sensor(bool recreate) {
      if (!mqtt_)
        return;

      const std::string topic_base = app_name_;
      const std::string unique_id = app_sanitize_name_ + "_mqtt_cmd_failure_counter_sensor";
      std::string config_topic = "homeassistant/sensor/" + topic_base + "-cmd-failure-counter/config";

      std::string payload = R"({
        "name": ")" + get_localized_name(app_lang_, "cmdFailureCounter") + R"(",
        "default_entity_id": ")" + "sensor." + unique_id + R"(",
        "unique_id": ")" + unique_id + R"(",
        "stat_t": ")" + topic_base + R"(/state",
        "icon": "mdi:alert-box",
        "val_tpl": "{{ value_json.cmd_failure_counter }}",
        "avty_t": ")" + topic_base + R"(/status",
        "pl_on": "true",
        "pl_off": "false",
        "pl_avail": "online",
        "pl_not_avail": "offline")" +
        build_common_config_suffix() + R"(
      })";

      if (recreate) {
        publish_async(config_topic, std::string(""), 1, true);
        set_timeout("publish_discovery_cmd_failure_counter_sensor", mqtt_delay_rebuild_, [this, config_topic, payload]() {
          publish_async(config_topic, payload, 1, true);
        });
      } else {
        publish_async(config_topic, payload, 1, true);
      }
    }

    void ACW02::publish_discovery_warn_text_sensor(bool recreate) {
      if (!mqtt_)
        return;

      const std::string topic_base = app_name_;
      const std::string unique_id = app_sanitize_name_ + "_mqtt_warn_text";
      std::string config_topic = "homeassistant/sensor/" + topic_base + "-warn-text/config";

      std::string payload = R"({
        "name": ")" + get_localized_name(app_lang_, "warnText") + R"(",
        "default_entity_id": ")" + "sensor." + unique_id + R"(",
        "unique_id": ")" + unique_id + R"(",
        "stat_t": ")" + topic_base + R"(/state",
        "val_tpl": "{{ value_json.warn_text }}",
        "icon": "mdi:alert-circle-outline",
        "avty_t": ")" + topic_base + R"(/status",
        "pl_avail": "online",
        "pl_not_avail": "offline")" +
        build_common_config_suffix() + R"(
      })";
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
