fouille/acw02_esphome/(commit log)

2025-08-21 retry if cmd tx but not recieve RX ACK in 200ms.... + exclude stuck retry when fp is 0
    [acw02.cpp]
2025-08-22 opti keepalive AC drift if wait in progress + autorize cmd with fp 0 when wait enable + add get status after max retry + log
    [acw02.cpp]
2025-08-22 add jitter on retry cmd
    [acw02.cpp]
2025-08-23 archive gerber for replace level shiffter
    [BOM_uart-conv_2025-08-23.csv, PCB_PCB_uart-conv_2025-08-23.json, PCB_uart-conv_2025-08-23.dxf, PickAndPlace_PCB_uart-conv_2025-08-23.csv]
2025-09-02 update doc for esp32 not compatible
2025-09-02 doc printing material
2025-09-02 move printing material (doc)
2025-09-08 beta pcb v1.1
    [PCB_PCB_climEspHome_esp32_d1_mini_2025-07-17.json, PCB_PCB_climEspHome_esp32_d1_mini_v1.1_2025-09-08.json, PCB_climEspHome_esp32_d1_mini_2025-07-17 (1).dxf, PCB_climEspHome_esp32_d1_mini_v1.1_2025-09-08.dxf]
2025-09-10 update pcb level shifter
    [BOM_uart-conv_2025-08-23.csv, PCB_PCB_uart-conv_2025-08-23.json, PCB_PCB_uart-conv_2025-09-10.json, PCB_uart-conv_2025-08-23.dxf, PCB_uart-conv_2025-09-10.dxf, PickAndPlace_PCB_uart-conv_2025-08-23.csv]
2025-09-13 pcb version lolin c3 mini / xiao c3-c6
    [PCB_PCB_climEspHome_esp32_lolin_c3_xiao_c3_c6_2025-09-13.json, PCB_climEspHome_esp32_lolin_c3_xiao_c3_c6_2025-09-13.dxf]
2025-09-19 files SN74LVC2T45DCUR
    [BOM_uart-conv_2025-08-23.csv, PCB_PCB_uart-conv_2025-09-10.json, PCB_uart-conv_2025-09-10.dxf, PickAndPlace_PCB_uart-conv_2025-08-23.csv]
2025-09-19 readme + files move
    [PCB_PCB_climEspHome_esp32_d1_mini_2025-07-17.json, PCB_PCB_climEspHome_esp32_d1_mini_v1.1_2025-09-08.json, PCB_climEspHome_esp32_d1_mini_2025-07-17 (1).dxf, PCB_climEspHome_esp32_d1_mini_v1.1_2025-09-08.dxf]
2025-09-19 readme + zip gerber + BOM + pick and place
    [BOM_uart-conv_2025-08-23.csv, PickAndPlace_PCB_uart-conv_2025-08-23.csv]
2025-09-27 prepare esp32 C3/C6
2025-09-27 gerber c3-c6
2025-09-27 3D files
    [support antenna flex free.stl, support antenna flex horizontal.stl, support antenna flex vertical.stl, support antenna rigid part A.stl, support antenna rigid part B.stl]
2025-09-27 src pcb c3 c6
    [PCB_PCB_climEspHome_esp32_lolin_c3_xiao_c3_c6_2025-09-27.json, PCB_climEspHome_esp32_lolin_c3_xiao_c3_c6_2025-09-27.dxf]
2025-09-27 force use external antenna for xiao c6
2025-10-05 Add individual power commands
2026-10-30 Déplace les fichiers matériel dans hardware/ et other/notUsed/
    3Dfiles/ -> hardware/3d-files/, PCB/ -> hardware/pcb/, notUsed/ -> other/notUsed/.
2026-10-30 Réorganise la documentation (docs/en, docs/fr) et la met à jour
    - Nouveau README, ancien conservé dans README_OLD.md, MIGRATION.md pour les nouveaux chemins
    - Identifiants (clé API, mots de passe OTA/AP/web) documentés dans secrets.yaml
    - Versions d'installation : ESPHome 2026.7.0 et Python 3.12
2026-10-30 Firmware : ESPHome 2026.7.0, commandes MQTT de mode et secrets
    Réorganisation : components/ -> firmware/components/, esphome-acw02-*.yaml -> firmware/configs/,
    docker/ -> tools/docker/, scripts .bat -> tools/scripts/, HA-esphome-builder/ et test-build/ -> other/.
    - Reprend les changements upstream jusqu'à la release 2026.7.17 (devildant/acw02_esphome) :
    compatibilité ESPHome 2026.7.0, correctifs MQTT, default_entity_id pour la discovery HA,
    build_flags, authentification web digest, Docker en Python 3.12
    - Corrige cmd_ac/mode_climate, intercepté par les topics individuels cmd_ac/mode_<x>
    - Les topics cmd_ac/mode_<x> passent par mode_climate (dry, fan et l'anglais étaient faux)
    - Bou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
2026-10-30 Ajoute un script de compilation multi-modules
    tools/scripts/build-devices.sh compile une image par module listé sous acw02_devices
    dans firmware/configs/secrets.yaml (non versionné), en substituant dev_name et
    dev_friendly. Les images OTA et factory sont copiées dans firmware/build/<nom>/.
    .gitignore : .venv/, firmware/build/ et __pycache__/ à tous les niveaux.
2026-10-30 Ajoute une référence MQTT (fr et en)
    docs/*/advanced/mqtt-reference.md décrit tous les topics publiés (state, status,
    disponibilités, last_seen, ping) et toutes les commandes cmd_ac/ et cmd/, avec
    leurs payloads, conditions et un aide-mémoire pour scripts et agents IA.
    Avertissement ajouté sur les pages qui citent des topics inexistants.
2026-10-30 Passe la version de référence à ESPHome 2026.7.4 (Mac Intel)
    ESPHome 2026.7.0 ne s'installe pas sur Mac Intel : il exige cryptography 49.0.0,
    qu'esptool interdit sur cette plateforme (corrigé en 2026.7.1). Upstream utilise 2026.7.4.
    - tools/docker/.env, docs Windows et modèle d'issue : 2026.7.4
    - Docs macOS : installation dans un .venv avec pip au lieu de brew install esphome@<version>,
    formule qui n'existe pas, et note sur Rust requis par cbor2 sur Mac Intel
    - tools/README.md : renvoi vers la doc macOS pour créer le .venv
